AdamC19/Musical_SSTC_Driver/README.md

# Musical Solid-State Tesla Coil Project
These are the hardware source files for my 2022 revision of my musical solid-state Tesla coil driver. 

This is a completely analog design. No firmware!

## Concept
The concept is not far off from my previous design, except for a few notable differences.
