AdamC19/Musical_SSTC_Driver/SSTC_Control_Board/README.md

# Control Board

Below is a simplified block-diagram of the control board:

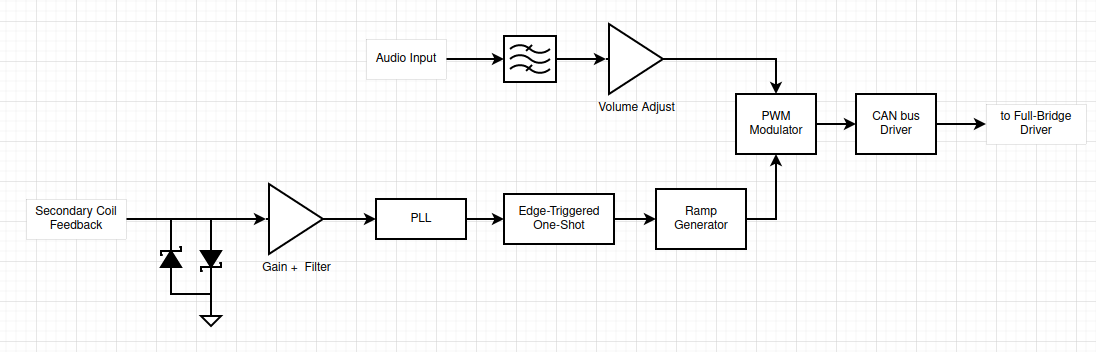
[picture p1: SSTC_Control_Board/imgs/control_board_block_diagram.png]
Control Board block diagram
