AdamC19/Musical_SSTC_Driver/SSTC_Full_Bridge_Driver/README.md

# Full-Bridge Driver
See below a simplified schematic of the full-bridge driver.

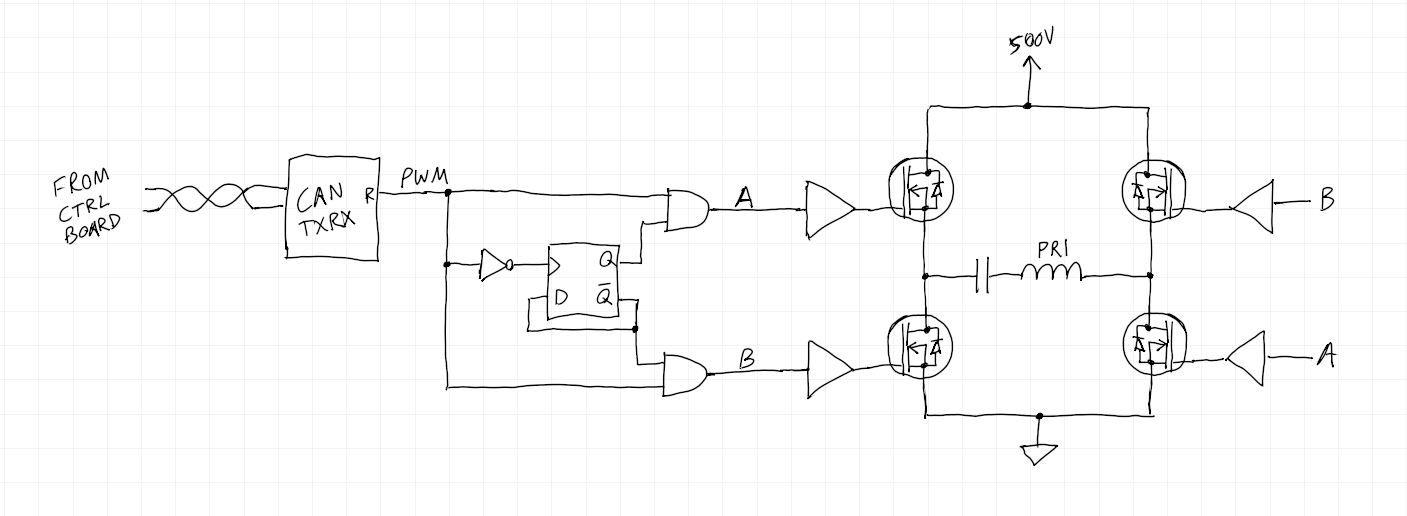
[picture p2: SSTC_Full_Bridge_Driver/imgs/full_bridge_simplified_schematic.png]
Simplified Schematic
