AdamC19/Musical_SSTC_Driver/SSTC_Switch_Board/SSTC_Switch_Board.step

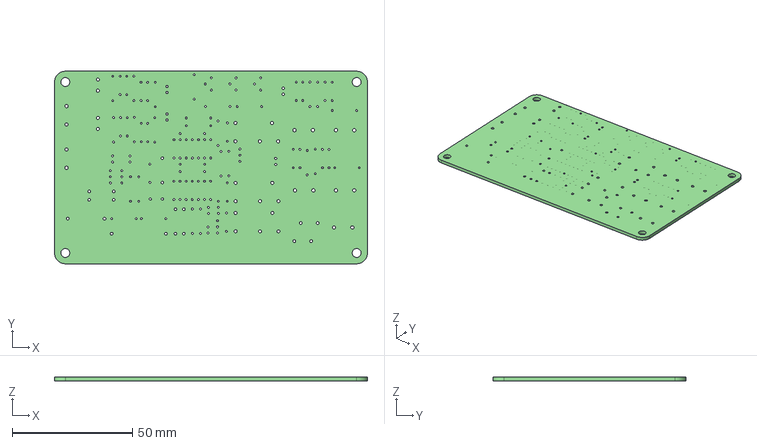
[picture p3: CAD file, 2022-02-14]
SSTC_Switch_Board/SSTC_Switch_Board.step
130.0 x 80.0 x 1.60 mm
