AdamC19/Musical_SSTC_Driver/SSTC_Control_Board/SSTC_Control_Board.kicad_pcb

## KiCad design SSTC_Control_Board/SSTC_Control_Board.kicad_pcb (2022-10-14)

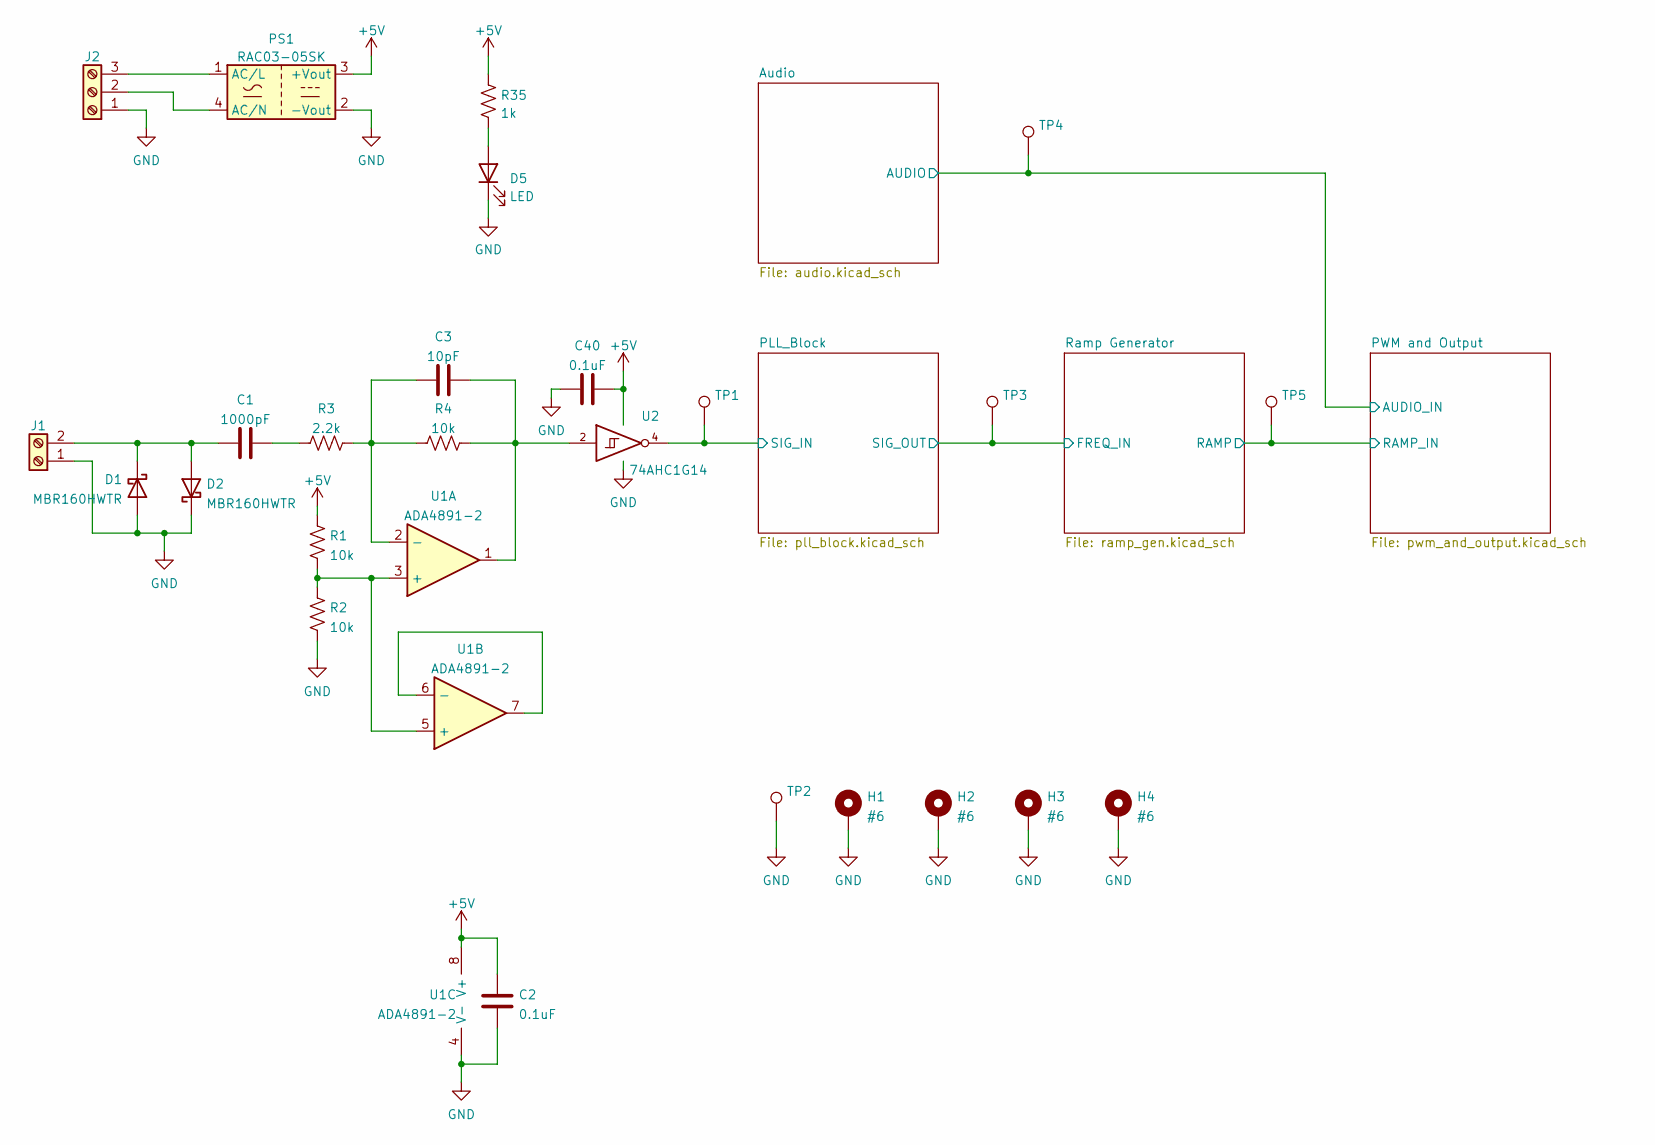
[picture p4: schematic SSTC_Control_Board.kicad_sch]

Parts:
C1: 1000pF; C_0603_1608Metric
C2, C40: 0.1uF; C_0603_1608Metric
C3: 10pF; C_0603_1608Metric
D1, D2: MBR160HWTR; D_SOD-123; MFG_PN MBR160HWTR
D5: LED; LED_0603_1608Metric
H1, H2, H3, H4: #6; MountingHole_3.7mm_Pad_Via
J1: Screw_Terminal_01x02; PhoenixContact_MC_1,5_2-G-3.81_1x02_P3.81mm_Horizontal
J2: Screw_Terminal_01x03; PhoenixContact_GMSTBA_2,5_3-G-7,62_1x03_P7.62mm_Horizontal
PS1: RAC03-05SK; RAC03-K; MFG_PN RAC03-05SK
R1, R2, R4: 10k; R_0805_2012Metric
R3: 2.2k; R_0805_2012Metric
R35: 1k; R_0805_2012Metric
TP1, TP2, TP3, TP4, TP5: TestPoint; TestPoint_Bridge_Pitch2.54mm_Drill1.0mm
U1: ADA4891-2; SOIC-8_3.9x4.9mm_P1.27mm
U2: 74AHC1G14; SOT-23-5

Connections:
+5V: C2.2, C40.1, PS1.3 (+Vout), R1.1, R35.2, U1.8 (V+), U2.5 (VCC); also elsewhere on the board
/Audio/AUDIO: TP4.1; also elsewhere on the board
/PLL_Block/SIG_IN: TP1.1, U2.4; also elsewhere on the board
/PLL_Block/SIG_OUT: TP3.1; also elsewhere on the board
/PWM and Output/RAMP_IN: TP5.1; also elsewhere on the board
GND: C2.1, C40.2, D1.2 (A), D2.1 (K), D5.1 (K), H1.1, H2.1, H3.1, H4.1, J1.1, J2.1, PS1.2 (-Vout), R2.2, TP2.1, U1.4 (V-), U2.3 (GND); also elsewhere on the board
unnamed: C1.1, D1.1 (K), D2.2 (A), J1.2
unnamed: C1.2, R3.1
unnamed: C3.1, R3.2, R4.1, U1.2 (-)
unnamed: C3.2, R4.2, U1.1, U2.2
unnamed: D5.2 (A), R35.1
unnamed: J2.2, PS1.4 (AC/N)
unnamed: J2.3, PS1.1 (AC/L)
unnamed: R1.2, R2.1, U1.3 (+), U1.5 (+)
unnamed: U1.6 (-), U1.7

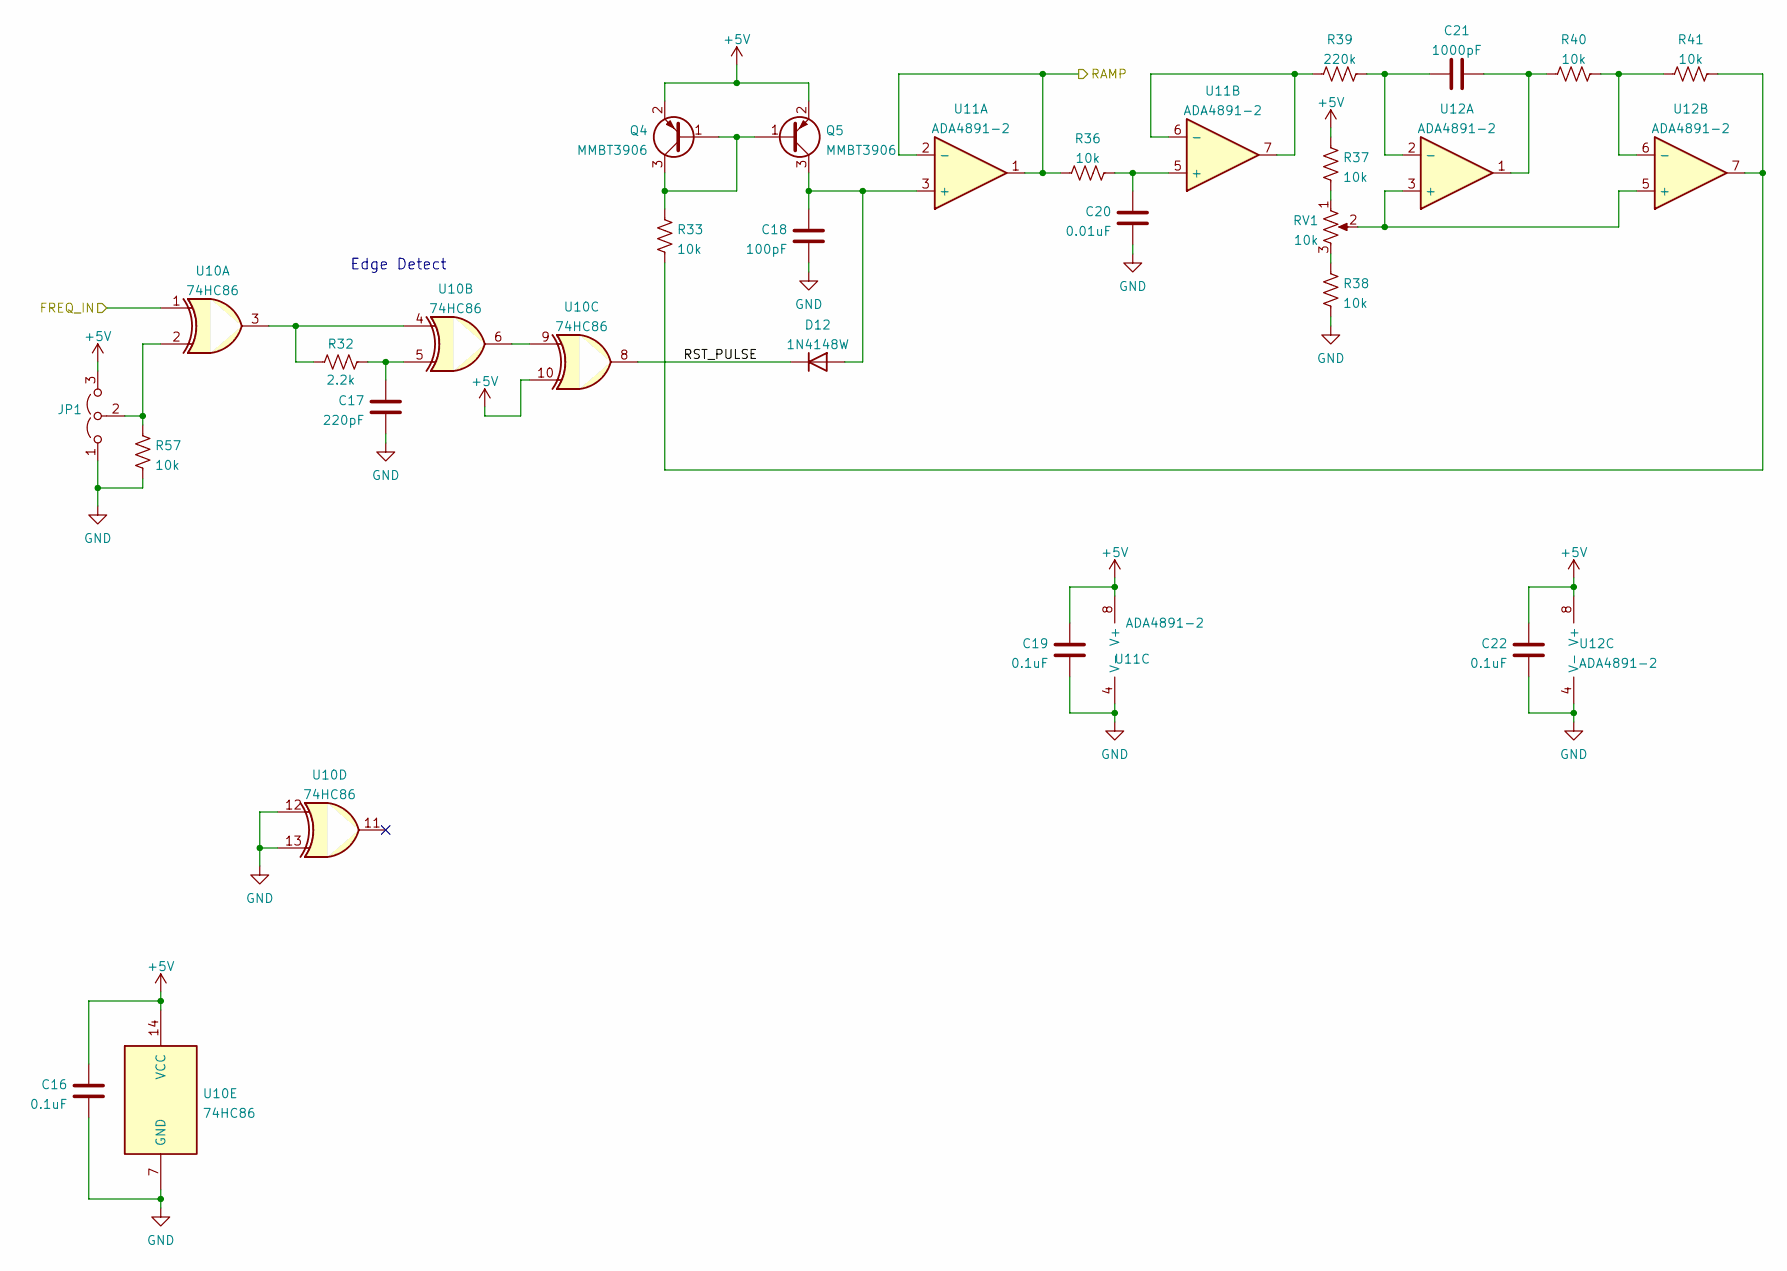
[picture p5: schematic ramp_gen.kicad_sch]

Parts:
C16, C19, C22: 0.1uF; C_0603_1608Metric
C17: 220pF; C_0603_1608Metric
C18: 100pF; C_0603_1608Metric
C20: 0.01uF; C_0603_1608Metric
C21: 1000pF; C_0603_1608Metric
D12: 1N4148W; D_SOD-123
JP1: Jumper_3_Open; PinHeader_1x03_P2.54mm_Vertical
Q4, Q5: MMBT3906; SOT-23
R32: 2.2k; R_0805_2012Metric
R33, R36, R37, R38, R40, R41, R57: 10k; R_0805_2012Metric
R39: 220k; R_0805_2012Metric
RV1: 10k; Potentiometer_Bourns_3386P_Vertical
U10: 74HC86; SOIC-14_3.9x8.7mm_P1.27mm
U11, U12: ADA4891-2; SOIC-8_3.9x4.9mm_P1.27mm

Connections:
+5V: C16.1, C19.1, C22.1, JP1.3 (B), Q4.2 (E), Q5.2 (E), R37.2, U10.10, U10.14 (VCC), U11.8 (V+), U12.8 (V+); also elsewhere on the board
/PLL_Block/SIG_OUT: U10.1; also elsewhere on the board
/PWM and Output/RAMP_IN: R36.1, U11.1, U11.2 (-); also elsewhere on the board
/Ramp Generator/RST_PULSE: D12.1 (K), U10.8
GND: C16.2, C17.2, C18.2, C19.2, C20.2, C22.2, JP1.1 (A), R38.1, R57.1, U10.7 (GND), U10.12, U10.13, U11.4 (V-), U12.4 (V-); also elsewhere on the board
unnamed: C17.1, R32.1, U10.5
unnamed: C18.1, D12.2 (A), Q5.3 (C), U11.3 (+)
unnamed: C20.1, R36.2, U11.5 (+)
unnamed: C21.1, R39.1, U12.2 (-)
unnamed: C21.2, R40.2, U12.1
unnamed: JP1.2 (C), R57.2, U10.2
unnamed: Q4.1 (B), Q4.3 (C), Q5.1 (B), R33.1
unnamed: R32.2, U10.3, U10.4
unnamed: R33.2, R41.1, U12.7
unnamed: R37.1, RV1.1
unnamed: R38.2, RV1.3
unnamed: R39.2, U11.6 (-), U11.7
unnamed: R40.1, R41.2, U12.6 (-)
unnamed: RV1.2, U12.3 (+), U12.5 (+)
unnamed: U10.6, U10.9

Notes on the sheet:
Edge Detect

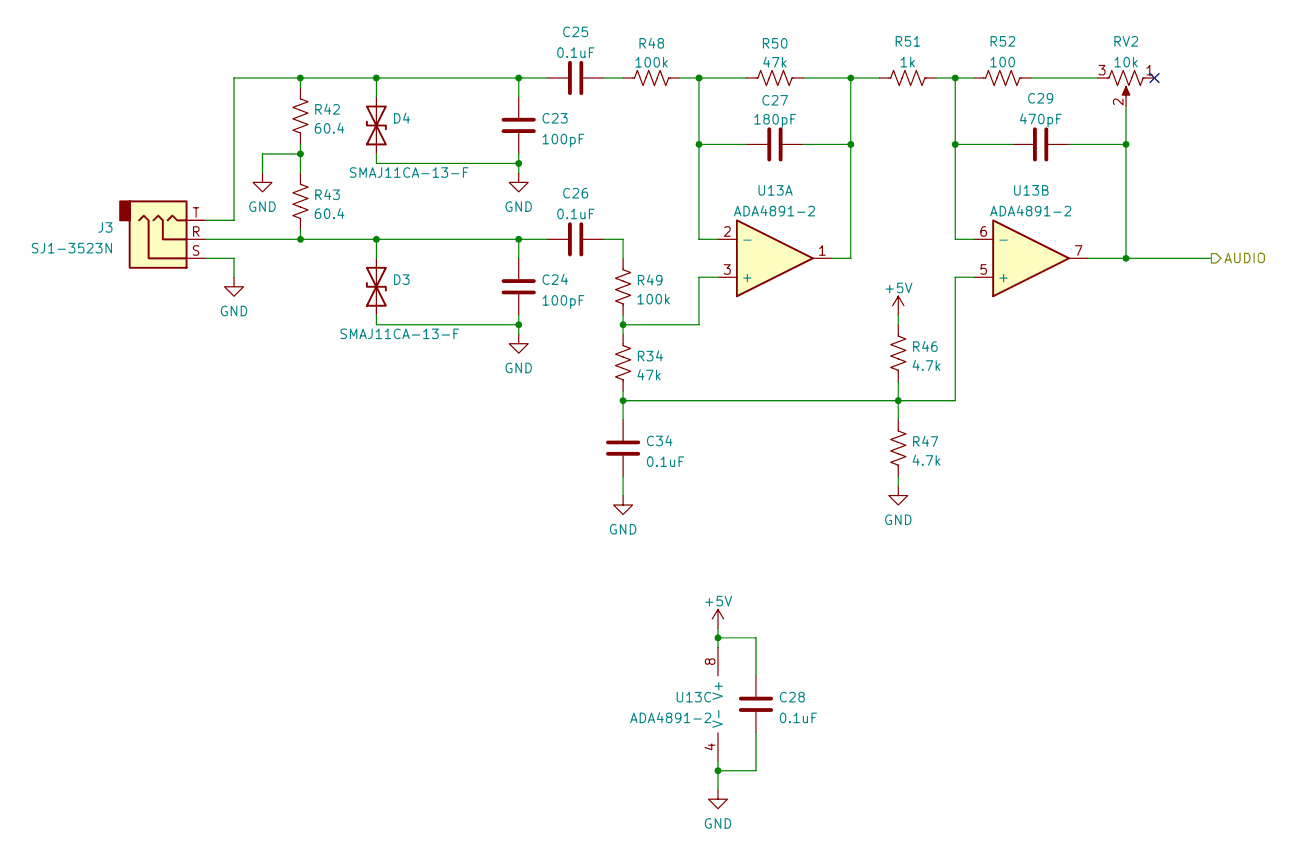
[picture p6: schematic audio.kicad_sch]

Parts:
C23, C24: 100pF; C_0603_1608Metric
C25, C26, C28, C34: 0.1uF; C_0603_1608Metric
C27: 180pF; C_0603_1608Metric
C29: 470pF; C_0603_1608Metric
D3, D4: SMAJ11CA-13-F; D_SMA; MFG_PN SMAJ11CA-13-F
J3: SJ1-3523N; Jack_3.5mm_CUI_SJ1-3523N_Horizontal; MFG_PN SJ1-3523N
R34, R50: 47k; R_0805_2012Metric
R42, R43: 60.4; R_0805_2012Metric
R46, R47: 4.7k; R_0805_2012Metric
R48, R49: 100k; R_0805_2012Metric
R51: 1k; R_0805_2012Metric
R52: 100; R_0805_2012Metric
RV2: 10k; Potentiometer_Bourns_PTV09A-2_Single_Horizontal; MFG_PN PTV09A-2020F-A103
U13: ADA4891-2; SOIC-8_3.9x4.9mm_P1.27mm

Connections:
+5V: C28.2, R46.2, U13.8 (V+); also elsewhere on the board
/Audio/AUDIO: C29.1, RV2.2, U13.7; also elsewhere on the board
GND: C23.1, C24.1, C28.1, C34.1, D3.1 (A1), D4.1 (A1), J3.S, R42.2, R43.1, R47.1, U13.4 (V-); also elsewhere on the board
unnamed: C23.2, C25.2, D4.2 (A2), J3.T, R42.1
unnamed: C24.2, C26.2, D3.2 (A2), J3.R, R43.2
unnamed: C25.1, R48.1
unnamed: C26.1, R49.2
unnamed: C27.1, R50.2, R51.1, U13.1
unnamed: C27.2, R48.2, R50.1, U13.2 (-)
unnamed: C29.2, R51.2, R52.2, U13.6 (-)
unnamed: C34.2, R34.1, R46.1, R47.2, U13.5 (+)
unnamed: R34.2, R49.1, U13.3 (+)
unnamed: R52.1, RV2.3

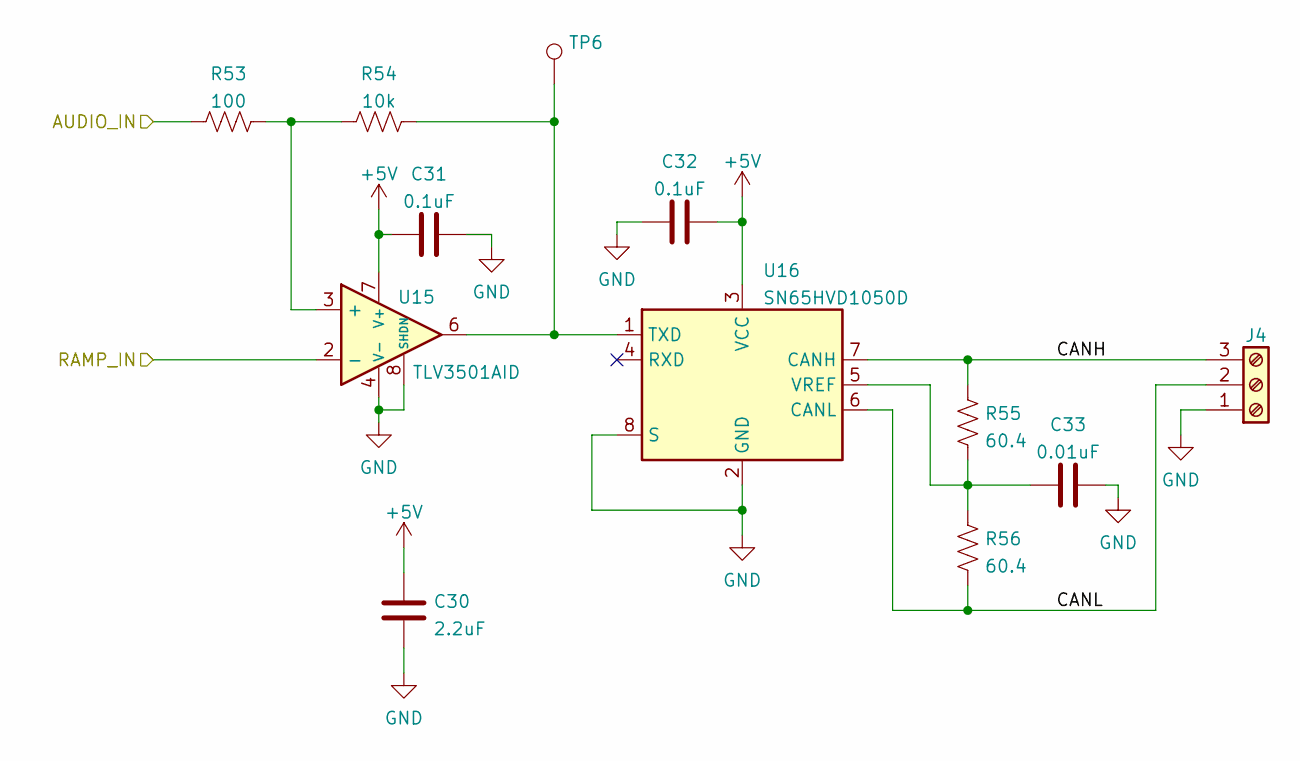
[picture p7: schematic pwm_and_output.kicad_sch]

Parts:
C30: 2.2uF; C_0805_2012Metric
C31, C32: 0.1uF; C_0603_1608Metric
C33: 0.01uF; C_0603_1608Metric
J4: Screw_Terminal_01x03; PhoenixContact_MC_1,5_3-G-3.81_1x03_P3.81mm_Horizontal
R53: 100; R_0805_2012Metric
R54: 10k; R_0805_2012Metric
R55, R56: 60.4; R_0805_2012Metric
TP6: TestPoint; TestPoint_Bridge_Pitch2.54mm_Drill1.0mm
U15: TLV3501AID; SOIC-8_3.9x4.9mm_P1.27mm
U16: SN65HVD1050D; SOIC-8_3.9x4.9mm_P1.27mm

Connections:
+5V: C30.2, C31.1, C32.1, U15.7 (V+), U16.3 (VCC); also elsewhere on the board
/Audio/AUDIO: R53.2; also elsewhere on the board
/PWM and Output/CANH: J4.3, R55.1, U16.7 (CANH)
/PWM and Output/CANL: J4.2, R56.2, U16.6 (CANL)
/PWM and Output/RAMP_IN: U15.2 (-); also elsewhere on the board
GND: C30.1, C31.2, C32.2, C33.2, J4.1, U15.4 (V-), U15.8 (SHDN), U16.2 (GND), U16.8 (S); also elsewhere on the board
unnamed: C33.1, R55.2, R56.1, U16.5 (VREF)
unnamed: R53.1, R54.1, U15.3 (+)
unnamed: R54.2, TP6.1, U15.6, U16.1 (TXD)

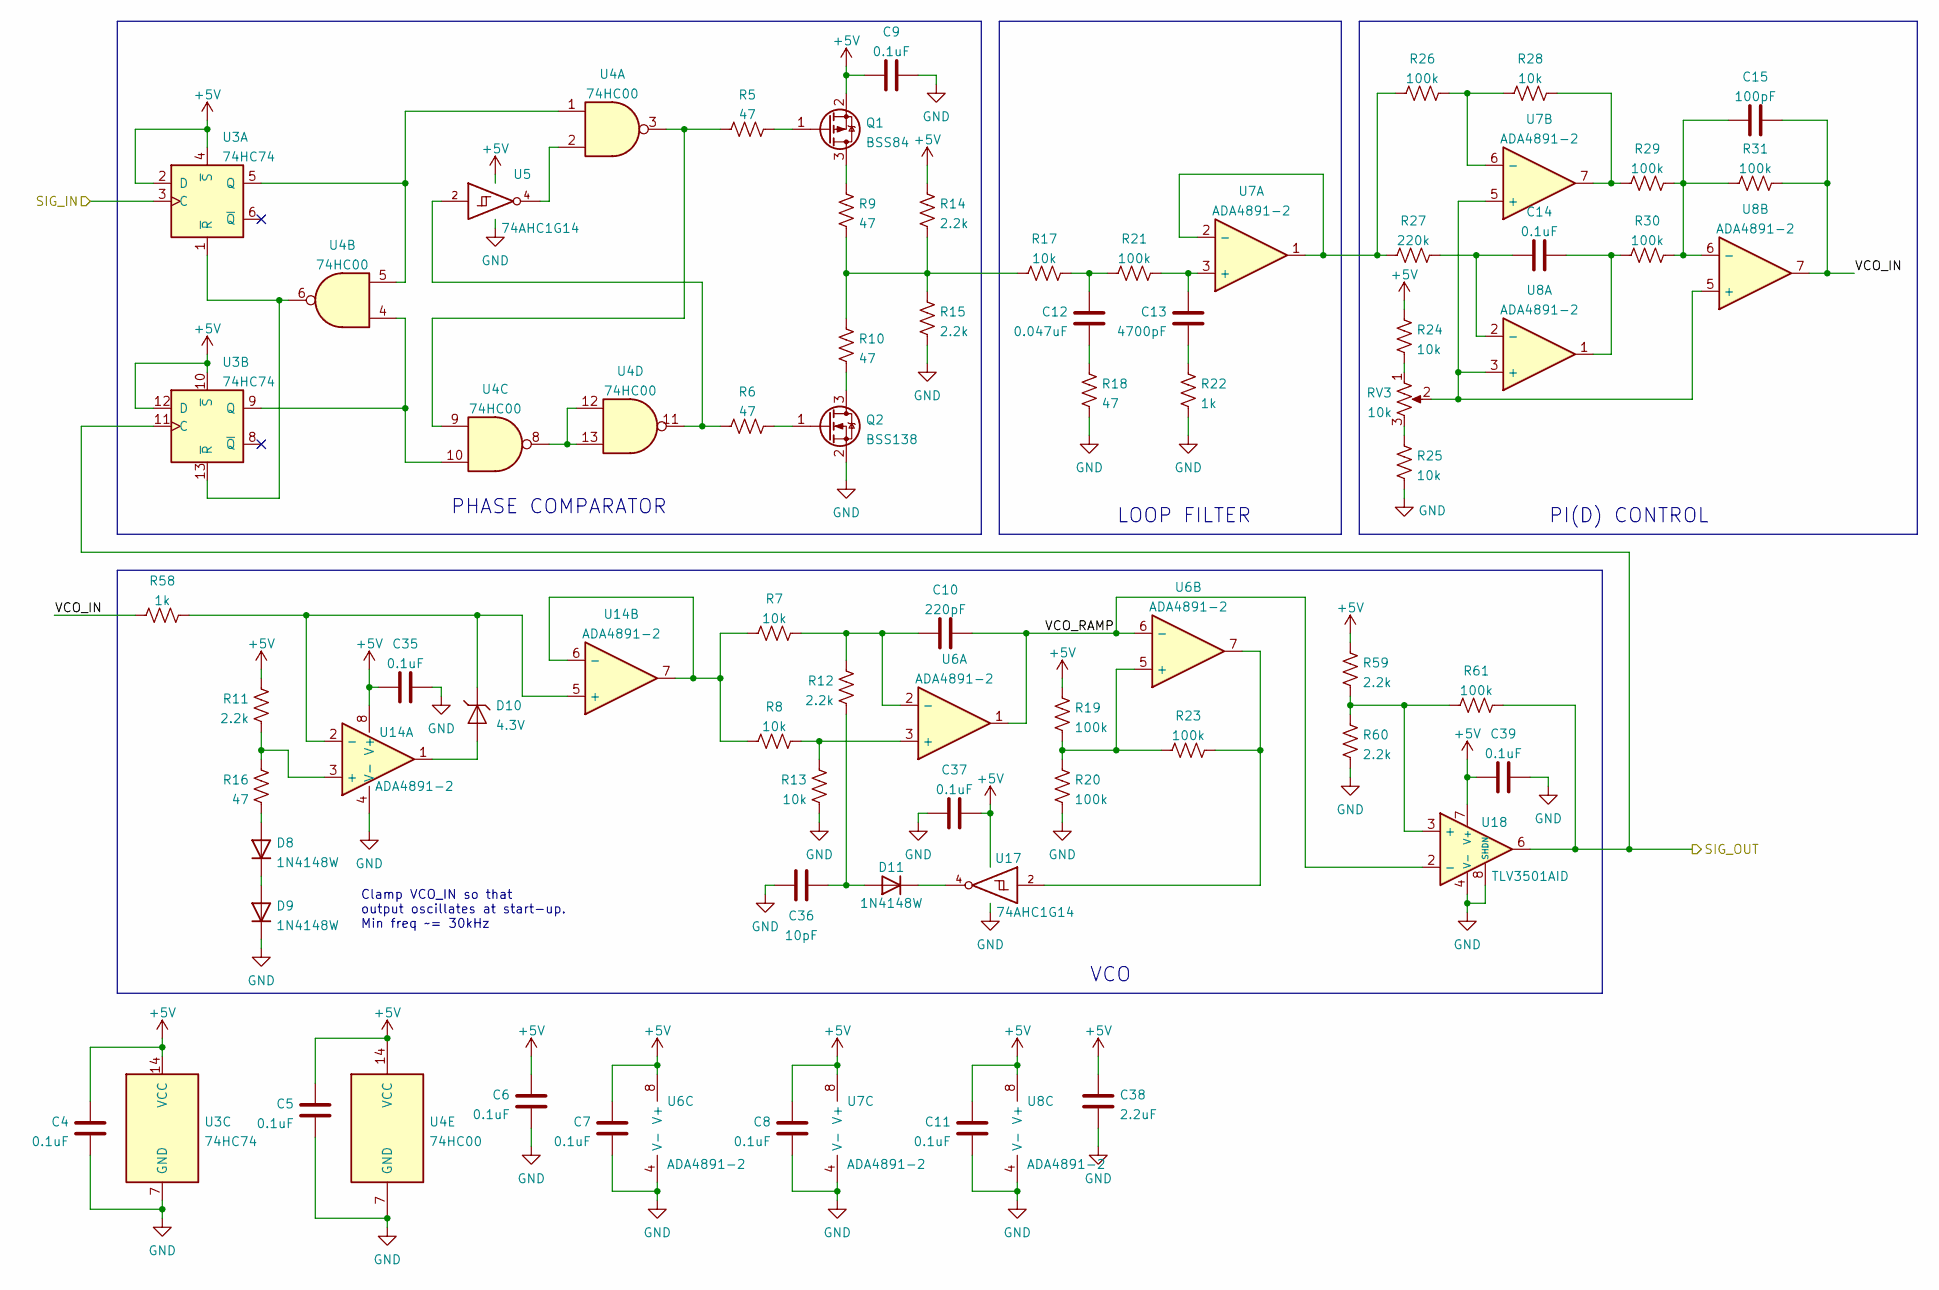
[picture p8: schematic pll_block.kicad_sch]

Parts:
C4, C5, C6, C7, C8, C9, C11, C14, C35, C37, C39: 0.1uF; C_0603_1608Metric
C10: 220pF; C_0603_1608Metric
C12: 0.047uF; C_0603_1608Metric
C13: 4700pF; C_0603_1608Metric
C15: 100pF; C_0603_1608Metric
C36: 10pF; C_0603_1608Metric
C38: 2.2uF; C_0805_2012Metric
D8, D9, D11: 1N4148W; D_SOD-123
D10: 4.3V; D_SOD-123; MFG_PN BZT52C4V3
Q1: BSS84; SOT-23
Q2: BSS138; SOT-23
R5, R6, R9, R10, R16, R18: 47; R_0805_2012Metric
R7, R8, R13, R17, R24, R25, R28: 10k; R_0805_2012Metric
R11, R12, R14, R15, R59, R60: 2.2k; R_0805_2012Metric
R19, R20, R21, R23, R26, R29, R30, R31, R61: 100k; R_0805_2012Metric
R22, R58: 1k; R_0805_2012Metric
R27: 220k; R_0805_2012Metric
RV3: 10k; Potentiometer_Bourns_3386P_Vertical
U3: 74HC74; SOIC-14_3.9x8.7mm_P1.27mm
U4: 74HC00; SOIC-14_3.9x8.7mm_P1.27mm
U5, U17: 74AHC1G14; SOT-23-5
U6, U7, U8, U14: ADA4891-2; SOIC-8_3.9x4.9mm_P1.27mm
U18: TLV3501AID; SOIC-8_3.9x4.9mm_P1.27mm

Connections:
+5V: C4.1, C5.1, C6.1, C7.1, C8.1, C9.1, C11.1, C35.1, C37.2, C38.2, C39.1, Q1.2 (S), R11.2, R14.2, R19.1, R24.1, R59.1, U3.2 (D), U3.4 (~S), U3.10 (~S), U3.12 (D), U3.14 (VCC), U4.14 (VCC), U5.5 (VCC), U6.8 (V+), U7.8 (V+), U8.8 (V+), U14.8 (V+), U17.5 (VCC), U18.7 (V+); also elsewhere on the board
/PLL_Block/SIG_IN: U3.3 (C); also elsewhere on the board
/PLL_Block/SIG_OUT: R61.2, U3.11 (C), U18.6; also elsewhere on the board
/PLL_Block/VCO_IN: C15.2, R31.1, R58.2, U8.7
/PLL_Block/VCO_RAMP: C10.2, U6.1, U6.6 (-), U18.2 (-)
GND: C4.2, C5.2, C6.2, C7.2, C8.2, C9.2, C11.2, C35.2, C36.1, C37.1, C38.1, C39.2, D9.1 (K), Q2.2 (S), R13.1, R15.1, R18.1, R20.2, R22.1, R25.2, R60.2, U3.7 (GND), U4.7 (GND), U5.3 (GND), U6.4 (V-), U7.4 (V-), U8.4 (V-), U14.4 (V-), U17.3 (GND), U18.4 (V-), U18.8 (SHDN); also elsewhere on the board
unnamed: C10.1, R7.2, R12.2, U6.2 (-)
unnamed: C12.1, R17.1, R21.2
unnamed: C12.2, R18.2
unnamed: C13.1, R21.1, U7.3 (+)
unnamed: C13.2, R22.2
unnamed: C14.1, R27.1, U8.2 (-)
unnamed: C14.2, R30.2, U8.1
unnamed: C15.1, R29.1, R30.1, R31.2, U8.6 (-)
unnamed: C36.2, D11.2 (A), R12.1
unnamed: D8.1 (K), D9.2 (A)
unnamed: D8.2 (A), R16.1
unnamed: D10.1 (K), R58.1, U14.2 (-), U14.5 (+)
unnamed: D10.2 (A), U14.1
unnamed: D11.1 (K), U17.4
unnamed: Q1.1 (G), R5.2
unnamed: Q1.3 (D), R9.2
unnamed: Q2.1 (G), R6.2
unnamed: Q2.3 (D), R10.1
unnamed: R5.1, U4.3, U4.9
unnamed: R6.1, U4.11, U5.2
unnamed: R7.1, R8.2, U14.6 (-), U14.7
unnamed: R9.1, R10.2, R14.1, R15.2, R17.2
unnamed: R11.1, R16.2, U14.3 (+)
unnamed: R8.1, R13.2, U6.3 (+)
unnamed: R19.2, R20.1, R23.1, U6.5 (+)
unnamed: R23.2, U6.7, U17.2
unnamed: R24.2, RV3.1
unnamed: R25.1, RV3.3
unnamed: R26.1, R28.2, U7.6 (-)
unnamed: R26.2, R27.2, U7.1, U7.2 (-)
unnamed: R28.1, R29.2, U7.7
unnamed: R59.2, R60.1, R61.1, U18.3 (+)
unnamed: RV3.2, U7.5 (+), U8.3 (+), U8.5 (+)
unnamed: U3.1 (~R), U3.13 (~R), U4.6
unnamed: U3.5 (Q), U4.1, U4.5
unnamed: U3.9 (Q), U4.4, U4.10
unnamed: U4.2, U5.4
unnamed: U4.8, U4.12, U4.13

Notes on the sheet:
LOOP FILTER
Clamp VCO_IN so that output oscillates at start-up. Min freq ~= 30kHz
VCO
PI(D) CONTROL
PHASE COMPARATOR

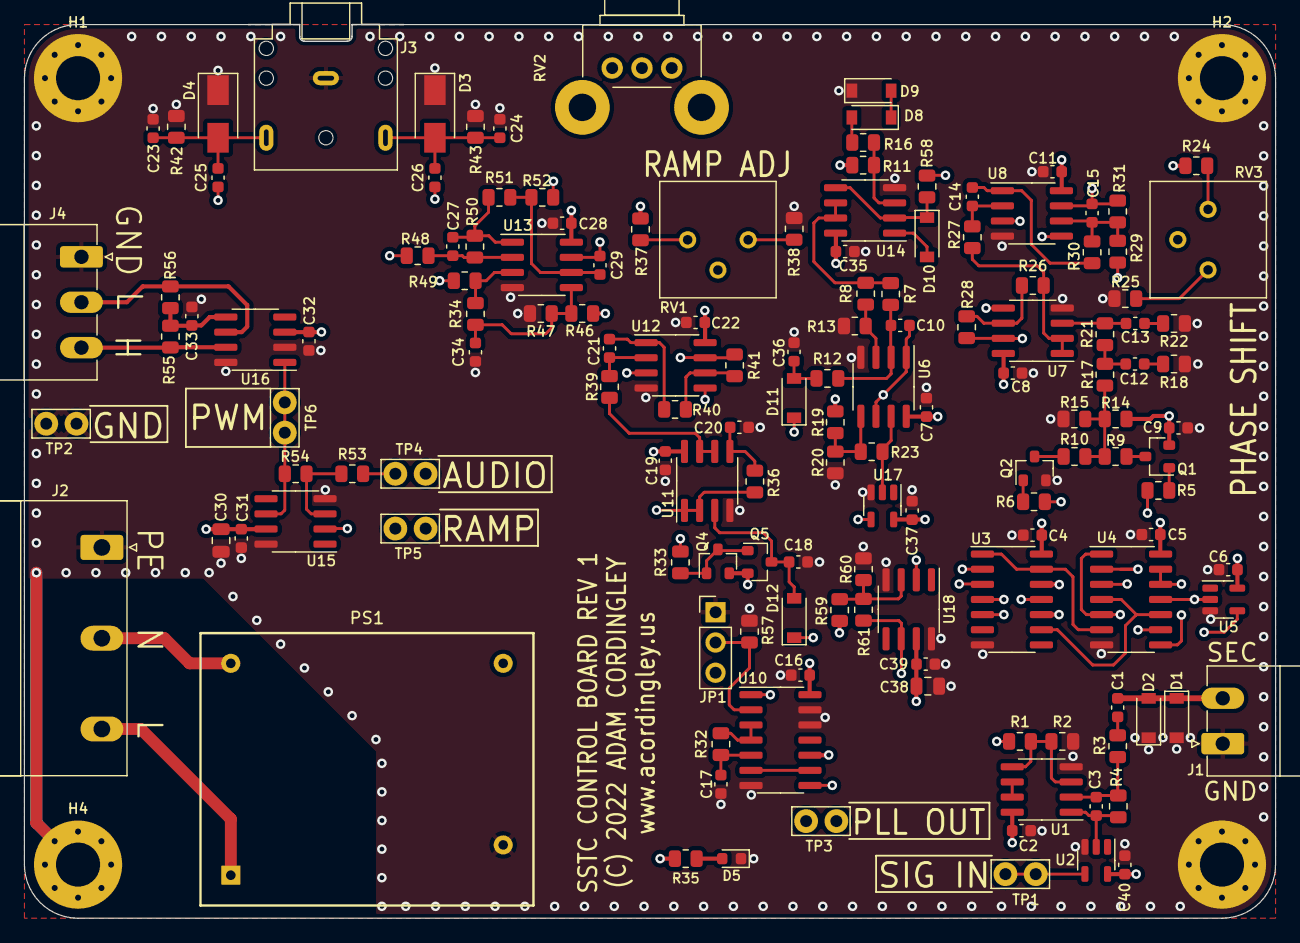
[picture p9: board SSTC_Control_Board.kicad_pcb from above]

Board: 4 copper layers, 105.0 x 75.0 mm, 149 parts (0 on the bottom side), 86 nets.
