AdamC19/Musical_SSTC_Driver/Audio_Isolator/Audio_Isolator.kicad_pcb

## KiCad design Audio_Isolator/Audio_Isolator.kicad_pcb (2022-10-14)

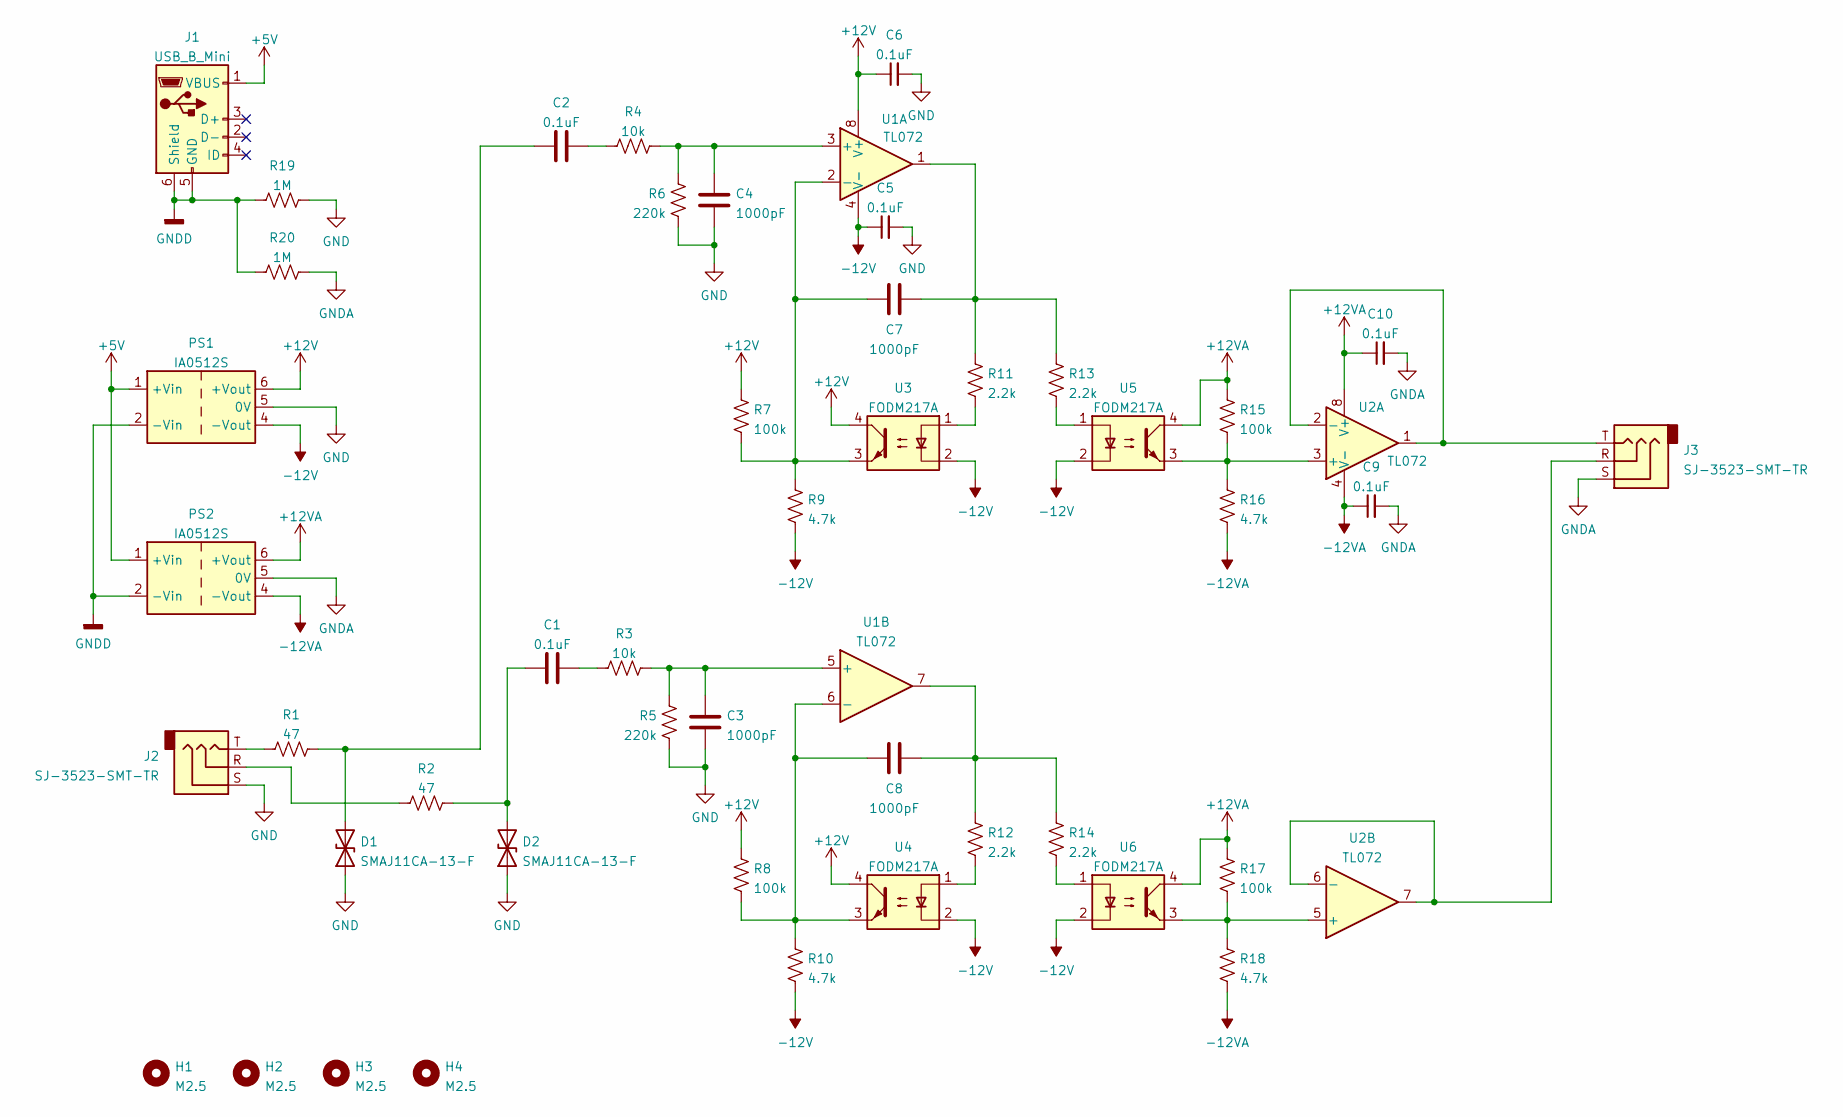
[picture p10: schematic Audio_Isolator.kicad_sch]

Parts:
C1, C2, C5, C6, C9, C10: 0.1uF; C_0603_1608Metric
C3, C4, C7, C8: 1000pF; C_0603_1608Metric
D1, D2: SMAJ11CA-13-F; D_SMA; MFG_PN SMAJ11CA-13-F
H1, H2, H3, H4: M2.5; MountingHole_2.7mm_M2.5_Pad
J1: USB_B_Mini; USB_Mini-B_Wuerth_65100516121_Horizontal
J2, J3: SJ-3523-SMT-TR; Jack_3.5mm_CUI_SJ-3523-SMT_Horizontal; MFG_PN SJ-3523-SMT-TR
PS1, PS2: IA0512S; Converter_DCDC_XP_POWER-IAxxxxS_THT
R1, R2: 47; R_0805_2012Metric
R3, R4: 10k; R_0805_2012Metric
R5, R6: 220k; R_0805_2012Metric
R7, R8, R15, R17: 100k; R_0805_2012Metric
R9, R10, R16, R18: 4.7k; R_0805_2012Metric
R11, R12, R13, R14: 2.2k; R_0805_2012Metric
R19, R20: 1M; R_2512_6332Metric
U1, U2: TL072; SOIC-8_3.9x4.9mm_P1.27mm
U3, U4, U5, U6: FODM217A; SOP-4_4.4x2.6mm_P1.27mm

Connections:
+5V: J1.1 (VBUS), PS1.1 (+Vin), PS2.1 (+Vin)
+12V: C6.1, PS1.6 (+Vout), R7.1, R8.1, U1.8 (V+), U3.4, U4.4
+12VA: C10.1, PS2.6 (+Vout), R15.1, R17.1, U2.8 (V+), U5.4, U6.4
-12V: C5.1, PS1.4 (-Vout), R9.2, R10.2, U1.4 (V-), U3.2, U4.2, U5.2, U6.2
-12VA: C9.1, PS2.4 (-Vout), R16.2, R18.2, U2.4 (V-)
GND: C3.2, C4.2, C5.2, C6.2, D1.1 (A1), D2.1 (A1), J2.S, PS1.5 (0V), R5.2, R6.2, R19.2
GNDA: C9.2, C10.2, J3.S, PS2.5 (0V), R20.2
GNDD: J1.5 (GND), J1.6 (Shield), PS1.2 (-Vin), PS2.2 (-Vin), R19.1, R20.1
unnamed: C1.1, D2.2 (A2), R2.2
unnamed: C1.2, R3.1
unnamed: C2.1, D1.2 (A2), R1.2
unnamed: C2.2, R4.1
unnamed: J2.R, R2.1
unnamed: J2.T, R1.1
unnamed: R11.2, U3.1
unnamed: R12.2, U4.1
unnamed: R13.2, U5.1
unnamed: R14.2, U6.1
unnamed: C7.1, R11.1, R13.1, U1.1
unnamed: C7.2, R7.2, R9.1, U1.2 (-), U3.3
unnamed: C4.1, R4.2, R6.1, U1.3 (+)
unnamed: C3.1, R3.2, R5.1, U1.5 (+)
unnamed: C8.2, R8.2, R10.1, U1.6 (-), U4.3
unnamed: C8.1, R12.1, R14.1, U1.7
unnamed: J3.T, U2.1, U2.2 (-)
unnamed: R15.2, R16.1, U2.3 (+), U5.3
unnamed: R17.2, R18.1, U2.5 (+), U6.3
unnamed: J3.R, U2.6 (-), U2.7

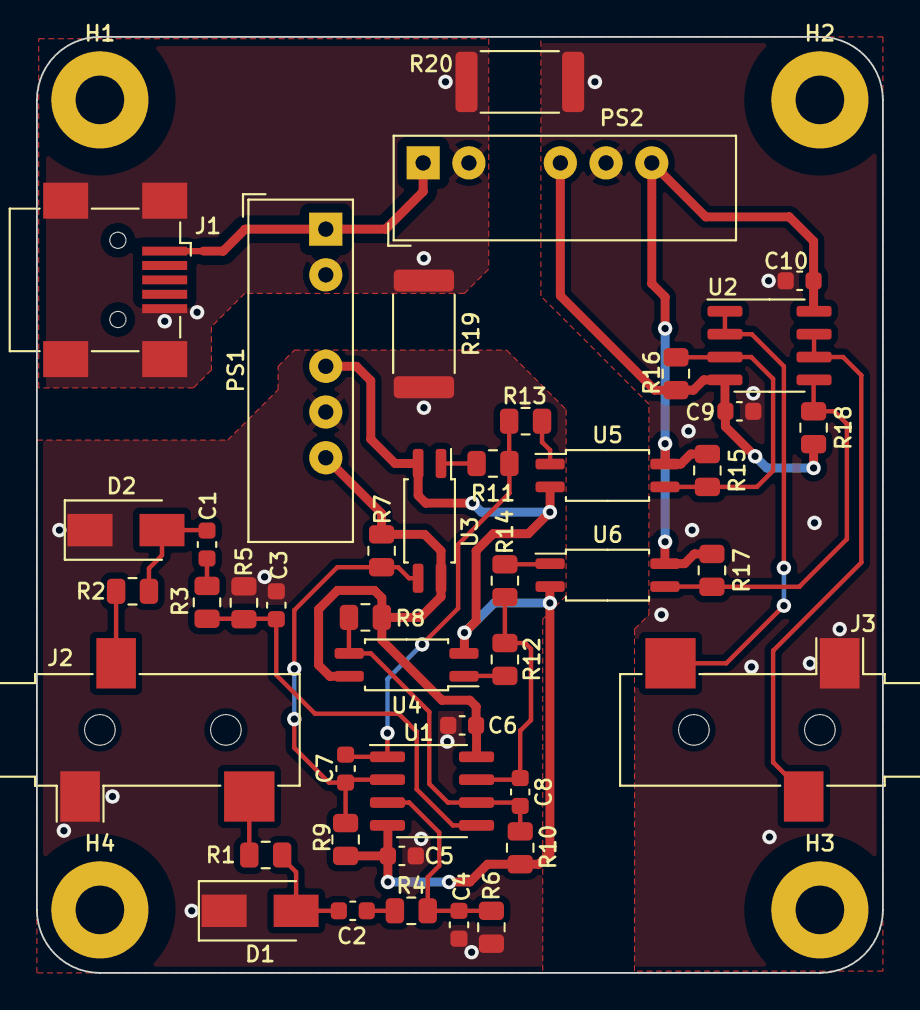
[picture p11: board Audio_Isolator.kicad_pcb from above]

Board: 2 copper layers, 47.0 x 52.0 mm, 47 parts (0 on the bottom side), 28 nets.
