AdamC19/Musical_SSTC_Driver/SSTC_Audio_Isolator/SSTC_Audio_Isolator.kicad_pcb

## KiCad design SSTC_Audio_Isolator/SSTC_Audio_Isolator.kicad_pcb (2022-10-14)

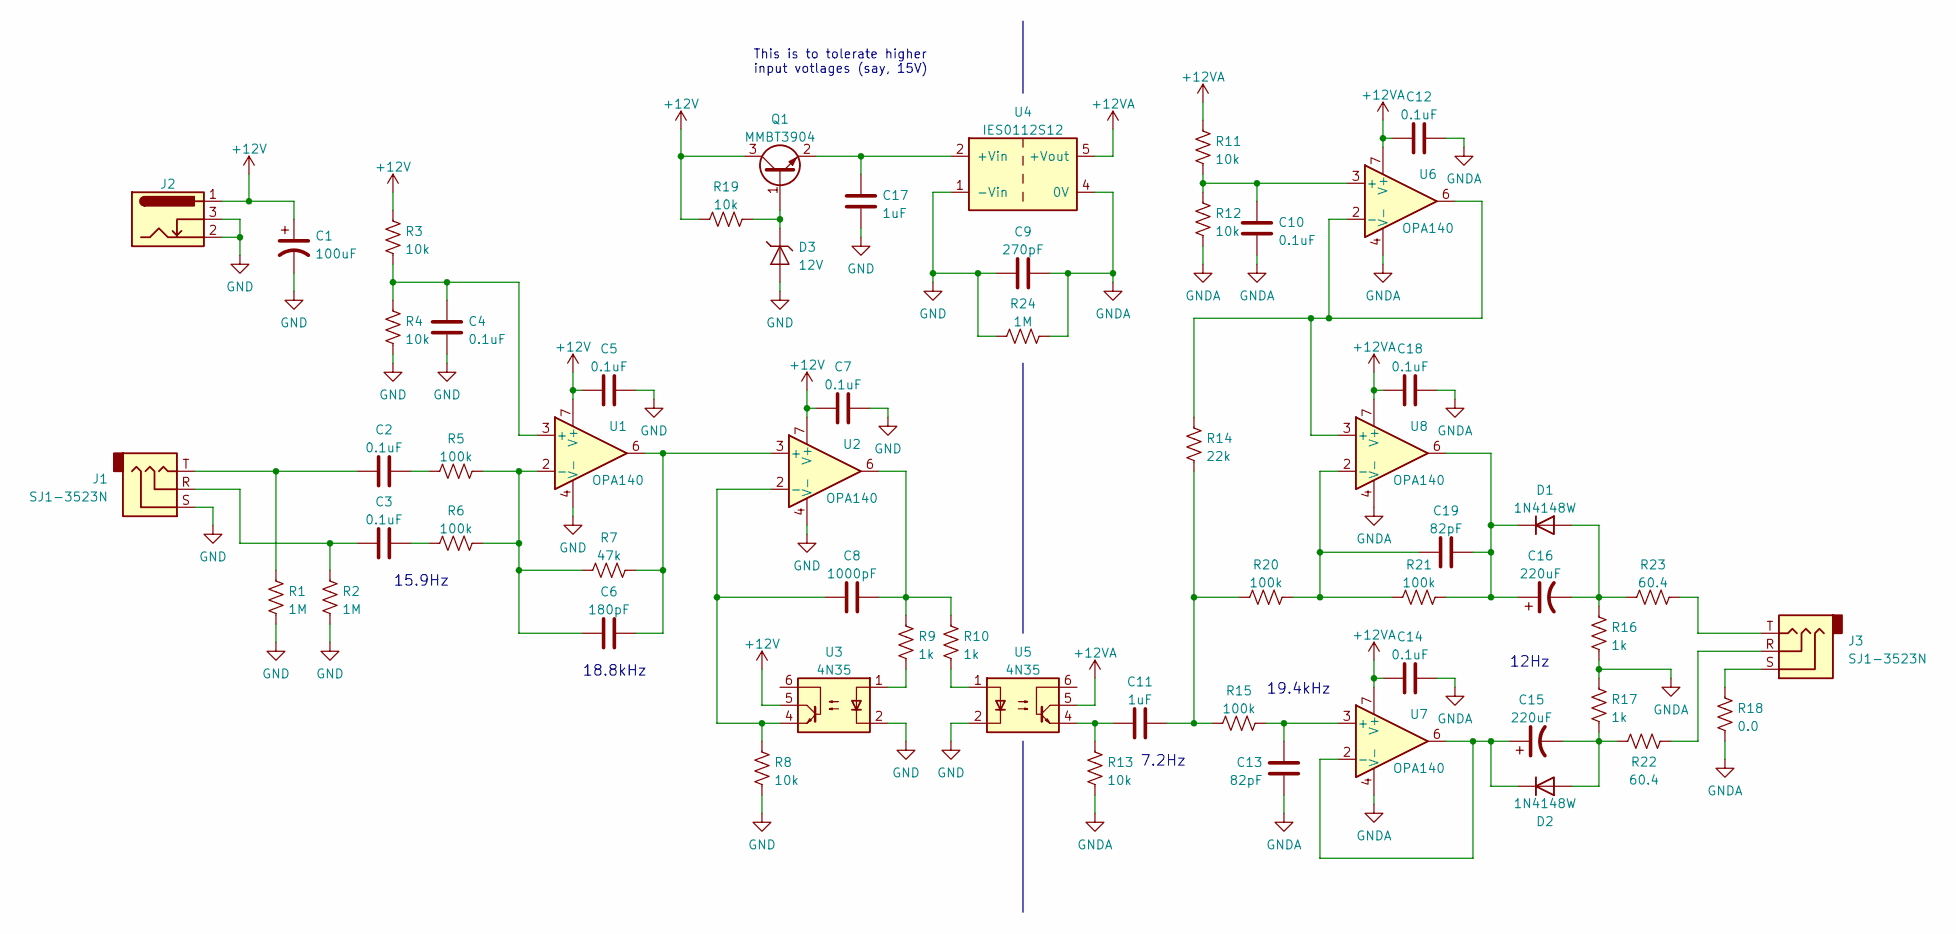
[picture p12: schematic SSTC_Audio_Isolator.kicad_sch]

Parts:
C1: 100uF; CP_Elec_6.3x9.9
C2, C3, C4, C5, C7, C10, C12, C14, C18: 0.1uF; C_0603_1608Metric
C6: 180pF; C_0603_1608Metric
C8: 1000pF; C_0603_1608Metric
C9: 270pF; C_1206_3216Metric
C11, C17: 1uF; C_0805_2012Metric
C13, C19: 82pF; C_0603_1608Metric
C15, C16: 220uF; CP_Elec_10x10
D1, D2: 1N4148W; D_SOD-123
D3: 12V; D_SOD-123
J1, J3: SJ1-3523N; Jack_3.5mm_CUI_SJ1-3523N_Horizontal; MFG_PN SJ1-3523N
J2: Barrel_Jack_Switch; BarrelJack_CUI_PJ-066A
Q1: MMBT3904; SOT-23
R1, R2: 1M; R_0603_1608Metric
R3, R4, R8, R11, R12, R13, R19: 10k; R_0603_1608Metric
R5, R6, R15, R20, R21: 100k; R_0603_1608Metric
R7: 47k; R_0603_1608Metric
R9, R10, R16, R17: 1k; R_0603_1608Metric
R14: 22k; R_0603_1608Metric
R18: 0.0; R_0805_2012Metric
R22, R23: 60.4; R_0805_2012Metric
R24: 1M; R_1206_3216Metric
U1, U2, U6, U7, U8: OPA140; SOIC-8_3.9x4.9mm_P1.27mm
U3, U5: 4N35; DIP-6_W7.62mm
U4: IES0112S12; XP_Power_ISE

Connections:
+12V: C1.1, C5.1, C7.1, J2.1, Q1.3 (C), R3.1, R19.1, U1.7 (V+), U2.7 (V+), U3.5
+12VA: C12.1, C14.1, C18.1, R11.2, U4.5 (+Vout), U5.5, U6.7 (V+), U7.7 (V+), U8.7 (V+)
GND: C1.2, C4.1, C5.2, C7.2, C9.1, C17.1, D3.2 (A), J1.S, J2.2, J2.3, R1.1, R2.1, R4.2, R8.1, R24.2, U1.4 (V-), U2.4 (V-), U3.2, U4.1 (-Vin), U5.2
GNDA: C9.2, C10.1, C12.2, C13.1, C14.2, C18.2, R12.1, R13.1, R16.1, R17.2, R18.1, R24.1, U4.4 (0V), U6.4 (V-), U7.4 (V-), U8.4 (V-)
unnamed: C2.1, J1.T, R1.2
unnamed: C2.2, R5.1
unnamed: C3.1, J1.R, R2.2
unnamed: C3.2, R6.1
unnamed: C4.2, R3.2, R4.1, U1.3 (+)
unnamed: C6.1, R5.2, R6.2, R7.1, U1.2 (-)
unnamed: C6.2, R7.2, U1.6, U2.3 (+)
unnamed: C8.1, R8.2, U2.2 (-), U3.4
unnamed: C8.2, R9.1, R10.1, U2.6
unnamed: C10.2, R11.1, R12.2, U6.3 (+)
unnamed: C11.1, R13.2, U5.4
unnamed: C11.2, R14.1, R15.2, R20.2
unnamed: C13.2, R15.1, U7.3 (+)
unnamed: C15.1, D2.1 (K), U7.2 (-), U7.6
unnamed: C15.2, D2.2 (A), R17.1, R22.2
unnamed: C16.1, C19.1, D1.1 (K), R21.1, U8.6
unnamed: C16.2, D1.2 (A), R16.2, R23.2
unnamed: C17.2, Q1.2 (E), U4.2 (+Vin)
unnamed: C19.2, R20.1, R21.2, U8.2 (-)
unnamed: D3.1 (K), Q1.1 (B), R19.2
unnamed: J3.R, R22.1
unnamed: J3.S, R18.2
unnamed: J3.T, R23.1
unnamed: R9.2, U3.1
unnamed: R10.2, U5.1
unnamed: R14.2, U6.2 (-), U6.6, U8.3 (+)

Notes on the sheet:
19.4kHz
7.2Hz
15.9Hz
This is to tolerate higher input votlages (say, 15V)
12Hz
18.8kHz
