AdamC19/Musical_SSTC_Driver/SSTC_Audio_Isolator/SSTC_Audio_Isolator.kicad_pcb

## KiCad design SSTC_Audio_Isolator/SSTC_Audio_Isolator.kicad_pcb (continued)

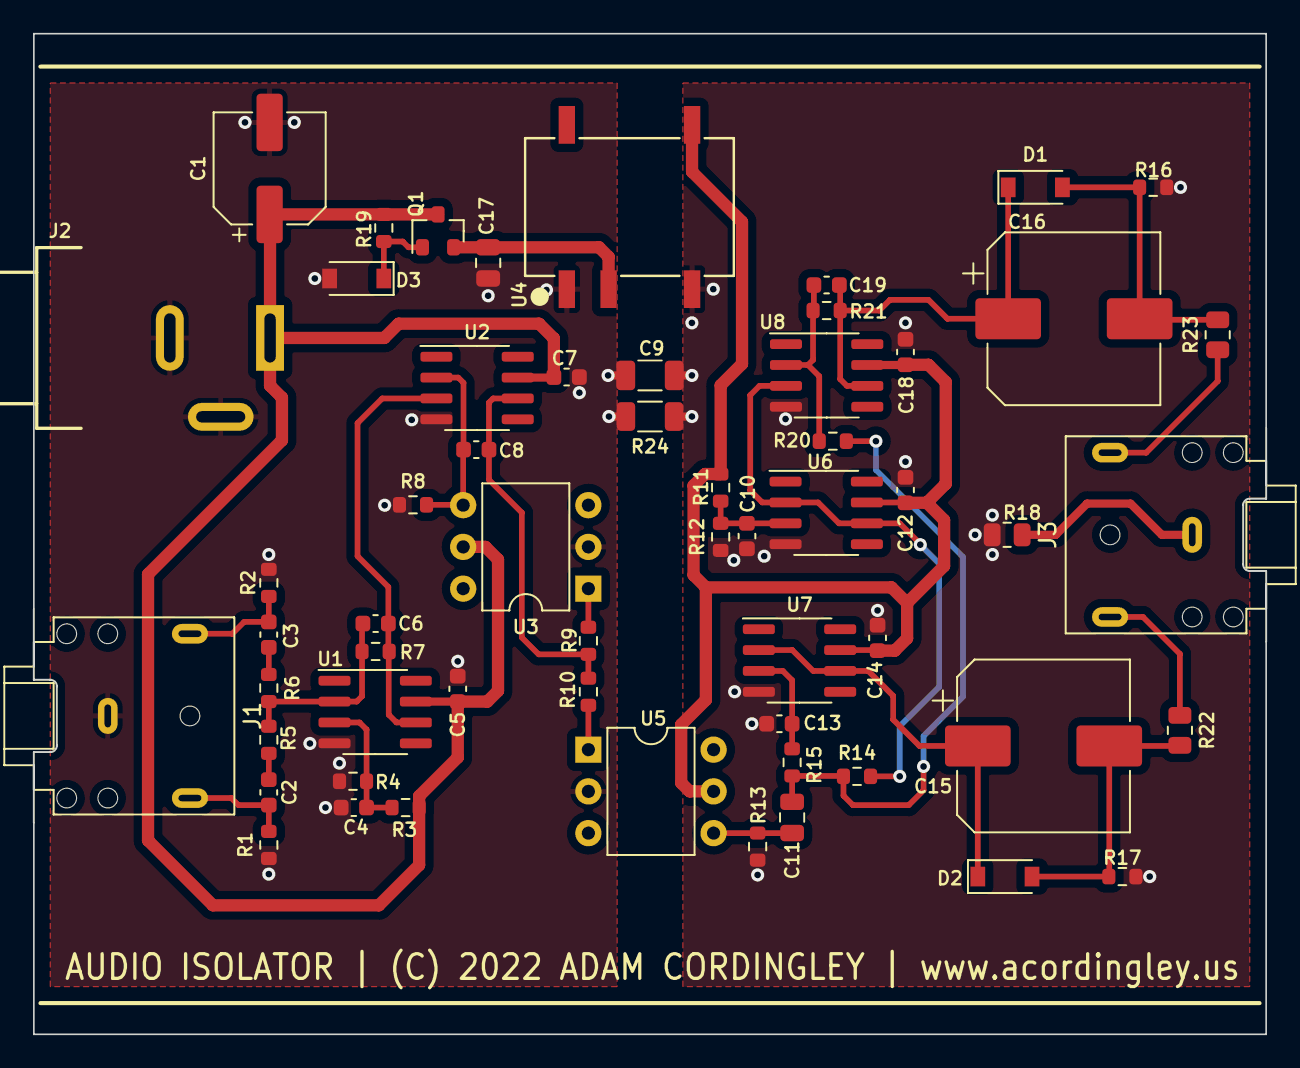
[picture p13: board SSTC_Audio_Isolator.kicad_pcb from above]

Board: 2 copper layers, 75.0 x 60.9 mm, 58 parts (0 on the bottom side), 30 nets.
