AdamC19/Musical_SSTC_Driver/SSTC_PFC_Power_Supply/SSTC_PFC_Power_Supply.kicad_pcb

## KiCad design SSTC_PFC_Power_Supply/SSTC_PFC_Power_Supply.kicad_pcb (2022-10-14)

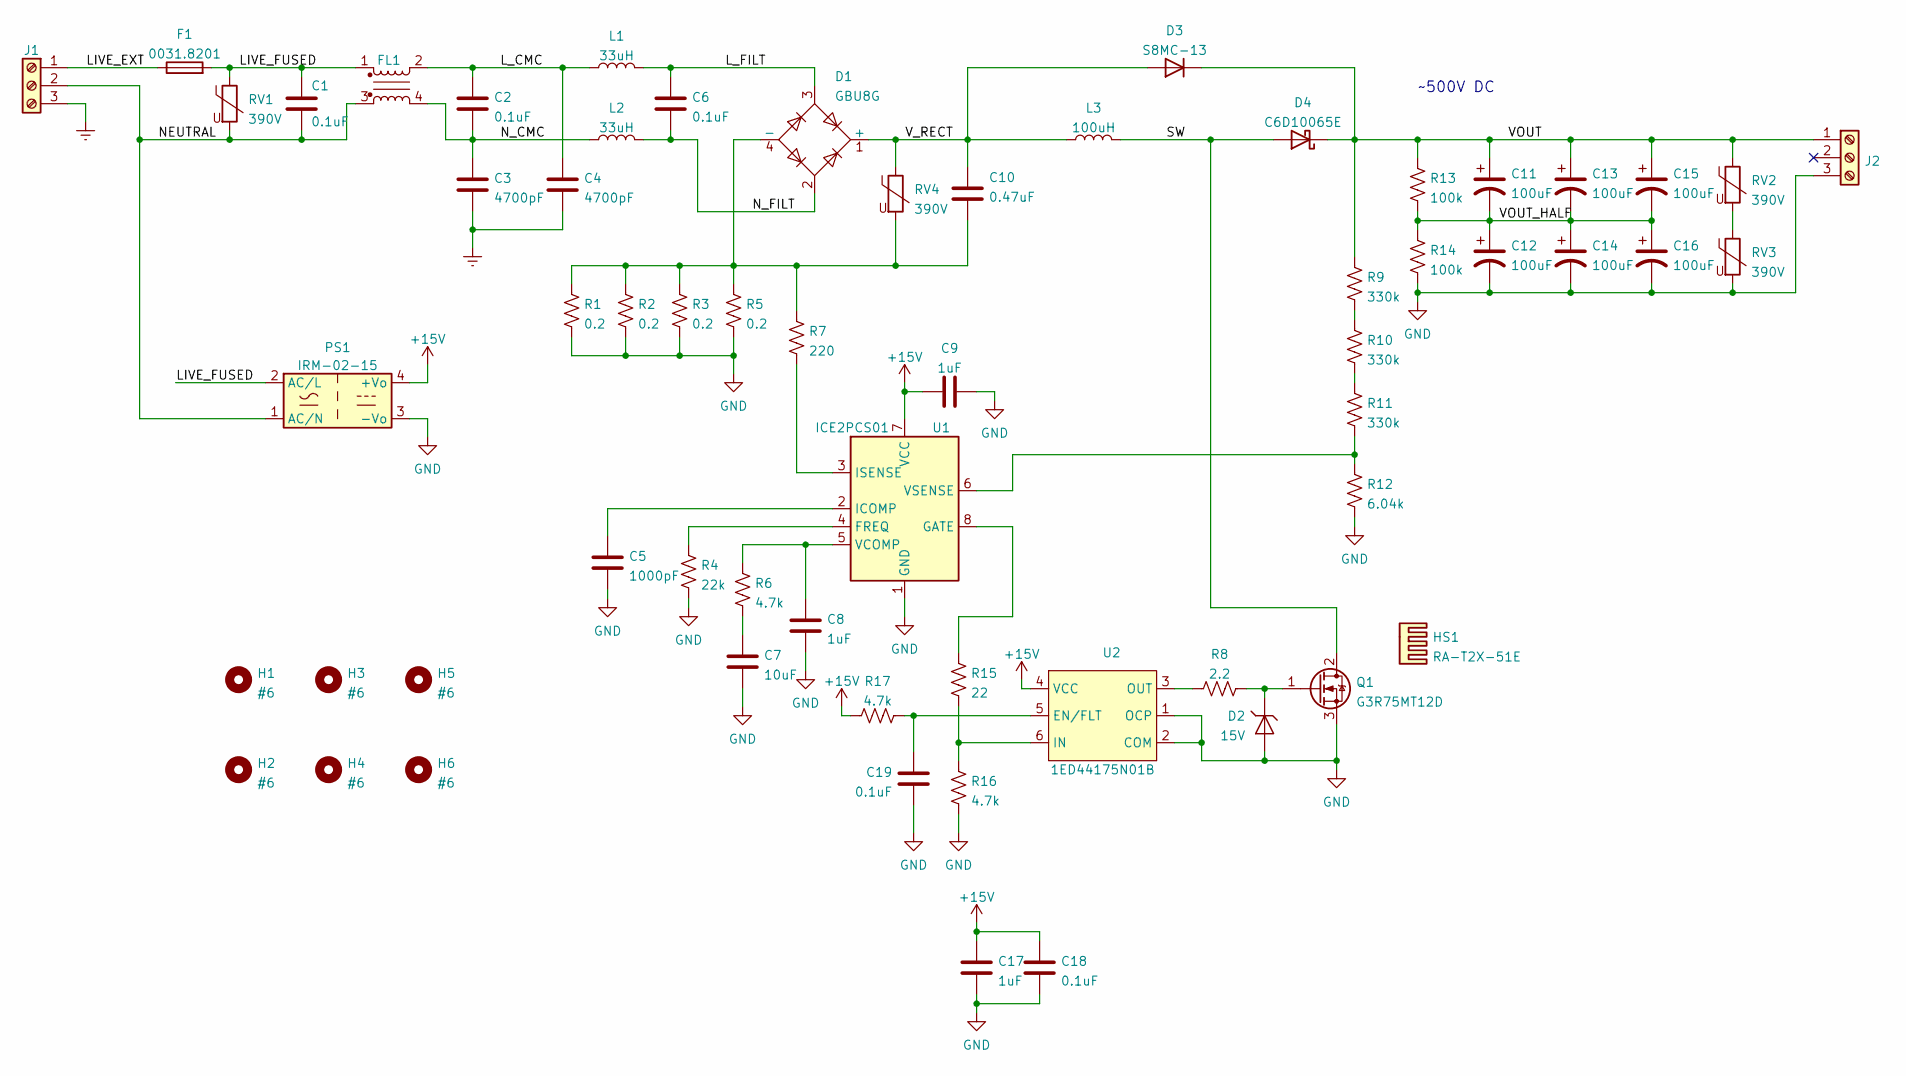
[picture p14: schematic SSTC_PFC_Power_Supply.kicad_sch]

Parts:
C1, C2, C6: 0.1uF; C_Rect_L18.0mm_W6.0mm_P15.00mm_FKS3_FKP3; MFG_PN PHE840MB6100MB05R17
C3, C4: 4700pF; C_Rect_L13.0mm_W4.0mm_P10.00mm_FKS3_FKP3_MKS4; MFG_PN R75PF1470AA01J
C5: 1000pF; C_0805_2012Metric
C7: 10uF; C_1206_3216Metric
C8, C9, C17: 1uF; C_0805_2012Metric
C10: 0.47uF; C_Rect_L18.0mm_W9.0mm_P15.00mm_FKS3_FKP3; MFG_PN B32922C3474K189
C11, C12, C13, C14, C15, C16: 100uF; CP_Radial_D18.0mm_P7.50mm; MFG_PN 450BXW100MEFR18X30
C18, C19: 0.1uF; C_0603_1608Metric
D1: GBU8G; Diode_Bridge_Vishay_GBU
D2: 15V; D_SOD-123
D3: S8MC-13; D_SMC; MFG_PN S8MC-13
D4: C6D10065E; TO-252-2_TabPin1_HV; MFG_PN C6D10065E
F1: 0031.8201; Fuseholder_Cylinder-5x20mm_Schurter_0031_8201_Horizontal_Op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; MFG_PN 0031.8201
FL1: 744824101; Weurth_WE-CMB; MFG_PN 744824101
H1, H2, H3, H4, H5, H6: #6; MountingHole_3.7mm_Pad
HS1: RA-T2X-51E; Ohmite_RA-T2X-51E; MFG_PN RA-T2X-51E
J1, J2: 1766246; PhoenixContact_GMSTBA_2,5_3-G-7,62_1x03_P7.62mm_Horizontal; MFG_PN 1766246
L1, L2: 33uH; L_Wuerth_HCI-2212; MFG_PN 74435583300
L3: 100uH; L_Bourns_1140-101K-RC; MFG_PN 1140-101K-RC
PS1: IRM-02-15; Converter_ACDC_MeanWell_IRM-02-xx_THT
Q1: G3R75MT12D; TO-247-3_Vertical; MFG_PN G3R75MT12D
R1, R2, R3, R5: 0.2; R_2512_6332Metric_High_Power; MFG_PN TLRP3A30CR200FTE
R4: 22k; R_0805_2012Metric
R6, R16, R17: 4.7k; R_0805_2012Metric
R7: 220; R_0805_2012Metric
R8: 2.2; R_0805_2012Metric
R9, R10, R11: 330k; R_1206_3216Metric
R12: 6.04k; R_0805_2012Metric
R13, R14: 100k; R_2512_6332Metric
R15: 22; R_0805_2012Metric
RV1, RV2, RV3, RV4: 390V; RV_Disc_D15.5mm_W4.9mm_P7.5mm; MFG_PN MOV-14D391K
U1: ICE2PCS01; SOIC-8_3.9x4.9mm_P1.27mm
U2: 1ED44175N01B; SOT-23-6; MFG_PN 1ED44175N01BXTSA1

Connections:
+15V: C9.2, C17.1, C18.1, PS1.4 (+Vo), R17.2, U1.7 (VCC), U2.4 (VCC)
/LIVE_EXT: F1.1, J1.1
/LIVE_FUSED: C1.1, F1.2, FL1.1, PS1.2 (AC/L), RV1.1
/L_CMC: C2.1, C4.1, FL1.2, L1.1
/L_FILT: C6.1, D1.3, L1.2
/NEUTRAL: C1.2, FL1.3, J1.2, PS1.1 (AC/N), RV1.2
/N_CMC: C2.2, C3.1, FL1.4, L2.1
/N_FILT: C6.2, D1.2, L2.2
/SW: D4.2 (A), L3.2, Q1.2 (D)
/VOUT: C11.1, C13.1, C15.1, D3.1 (K), D4.1 (K), J2.1, R9.2, R13.2, RV2.1
/VOUT_HALF: C11.2, C12.1, C13.2, C14.1, C15.2, C16.1, R13.1, R14.2
/V_RECT: C10.1, D1.1 (+), D3.2 (A), L3.1, RV4.1
Earth: C3.2, C4.2, J1.3
GND: C5.1, C7.1, C8.1, C9.1, C12.2, C14.2, C16.2, C17.2, C18.2, C19.2, D2.2 (A), J2.3, PS1.3 (-Vo), Q1.3 (S), R1.1, R2.1, R3.1, R4.1, R5.1, R12.1, R14.1, R16.1, RV3.2, U1.1 (GND), U2.1 (OCP), U2.2 (COM)
unnamed: C5.2, U1.2 (ICOMP)
unnamed: C7.2, R6.1
unnamed: C8.2, R6.2, U1.5 (VCOMP)
unnamed: C10.2, D1.4 (-), R1.2, R2.2, R3.2, R5.2, R7.2, RV4.2
unnamed: C19.1, R17.1, U2.5 (EN/FLT)
unnamed: D2.1 (K), Q1.1 (G), R8.1
unnamed: R4.2, U1.4 (FREQ)
unnamed: R7.1, U1.3 (ISENSE)
unnamed: R8.2, U2.3 (OUT)
unnamed: R10.1, R11.2
unnamed: R9.1, R10.2
unnamed: R11.1, R12.2, U1.6 (VSENSE)
unnamed: R15.1, U1.8 (GATE)
unnamed: R15.2, R16.2, U2.6 (IN)
unnamed: RV2.2, RV3.1

Notes on the sheet:
~500V DC

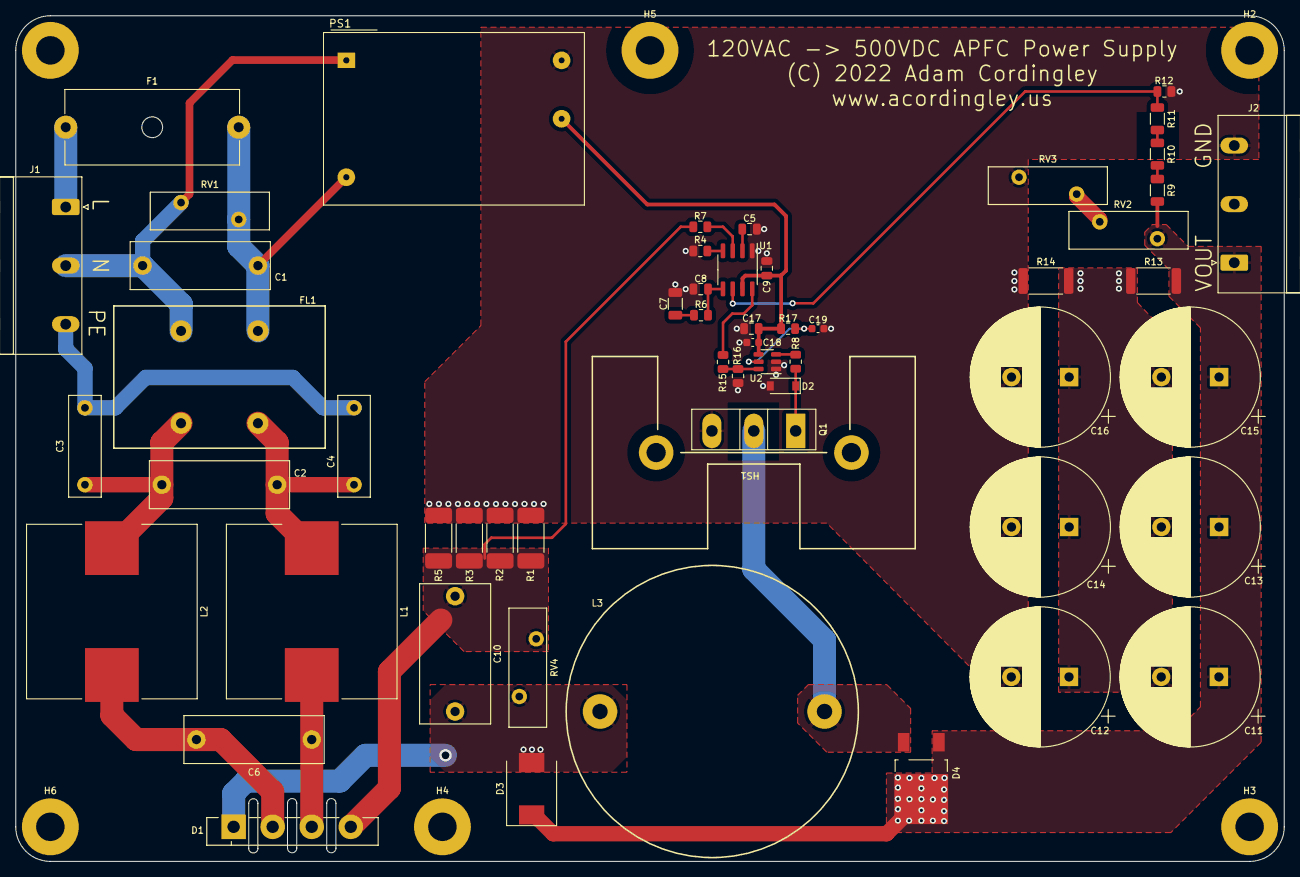
[picture p15: board SSTC_PFC_Power_Supply.kicad_pcb from above]

Board: 2 copper layers, 165.0 x 110.0 mm, 62 parts (0 on the bottom side), 29 nets.
