AdamC19/Musical_SSTC_Driver/SSTC_Power_Switcher/SSTC_Power_Switcher.kicad_pcb

## KiCad design SSTC_Power_Switcher/SSTC_Power_Switcher.kicad_pcb (2022-10-14)

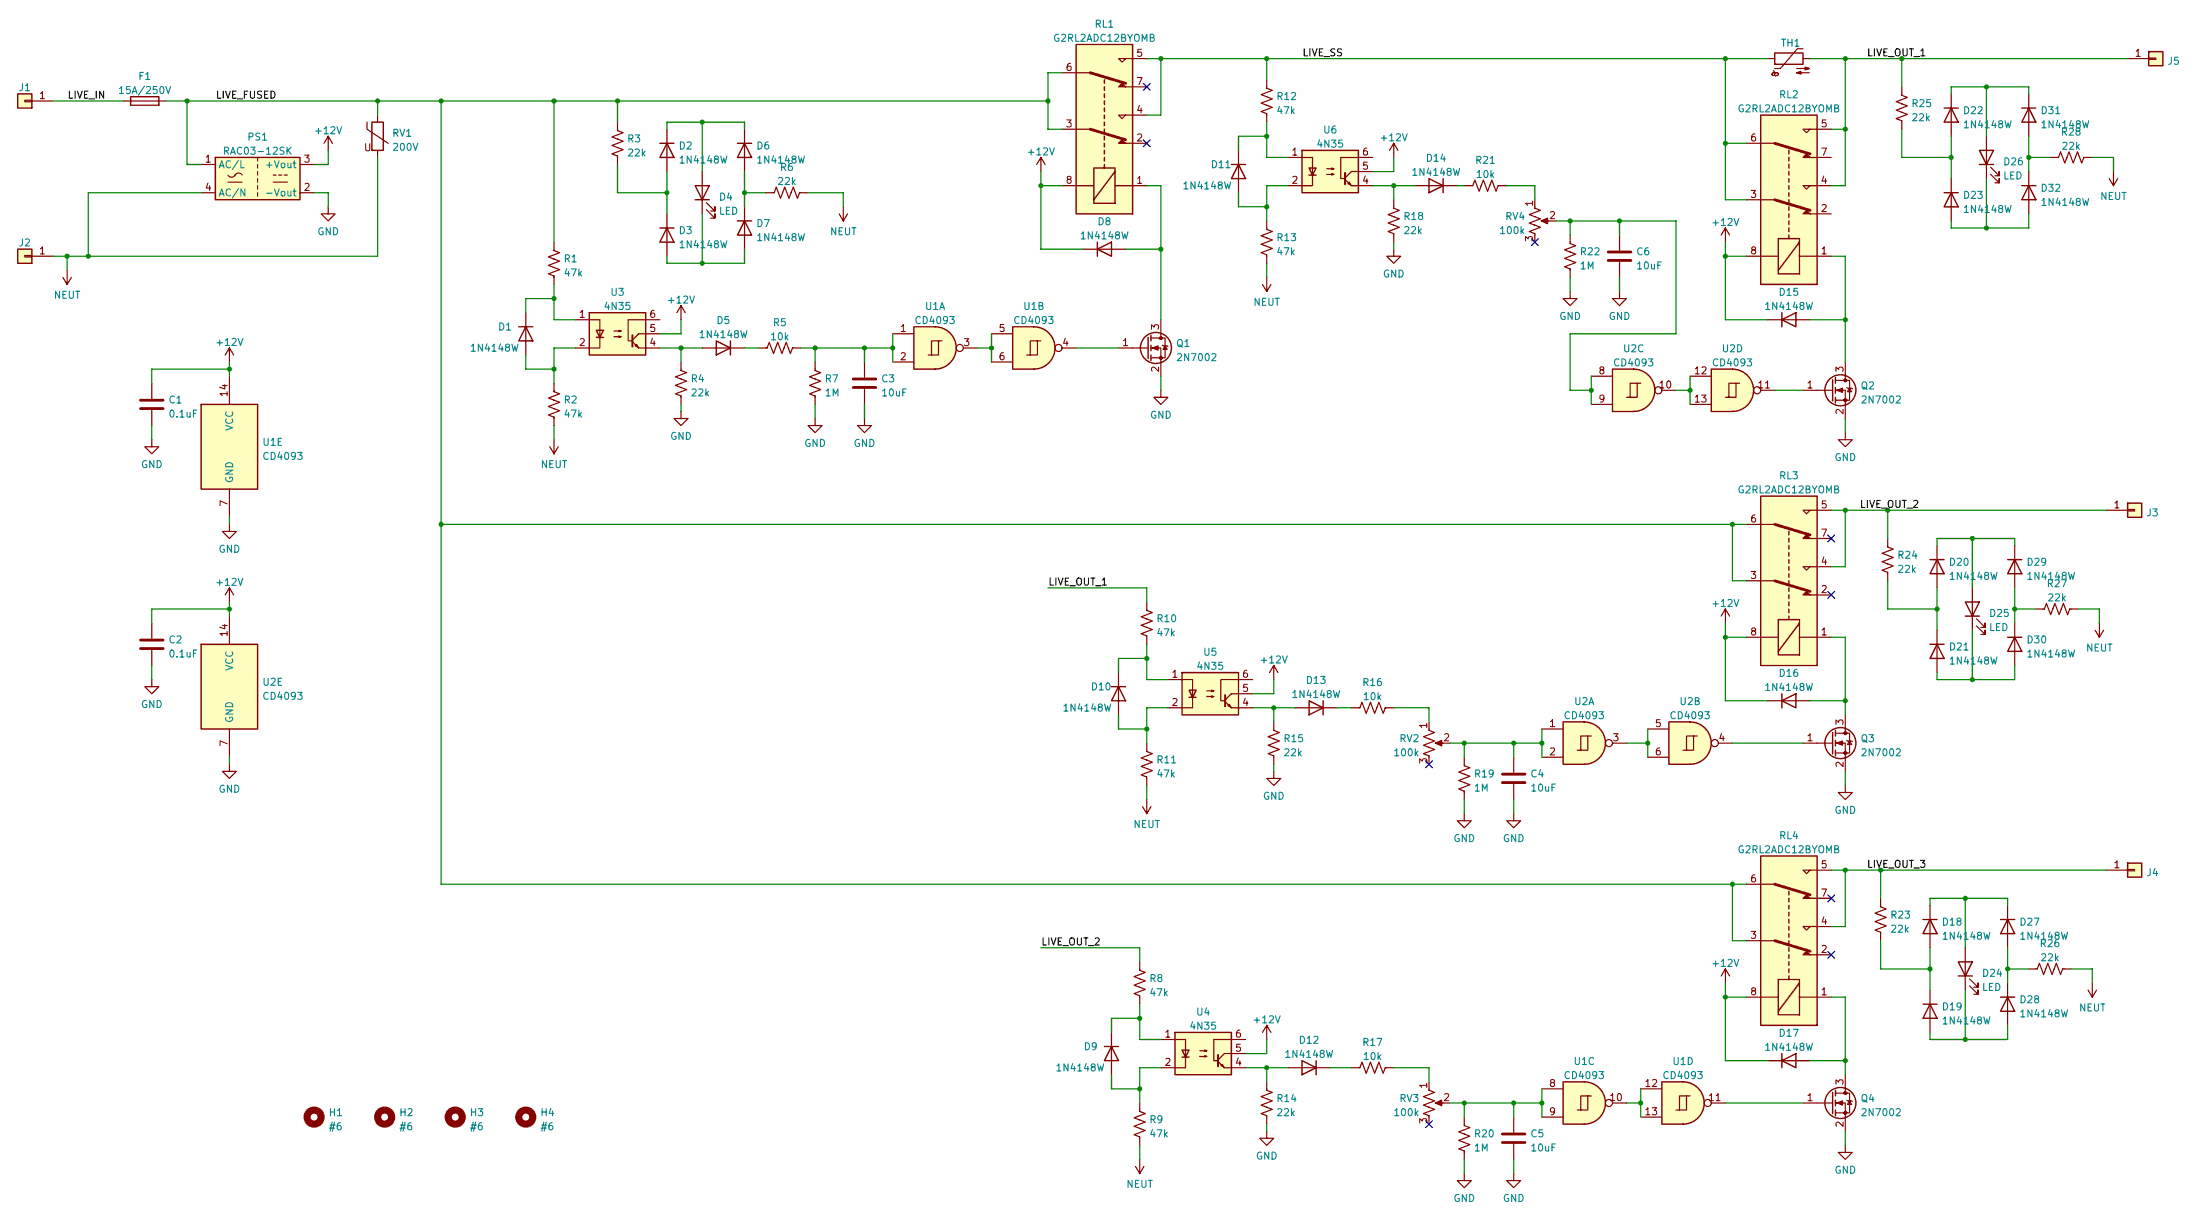
[picture p16: schematic SSTC_Power_Switcher.kicad_sch]

Parts:
C1, C2: 0.1uF; C_0603_1608Metric
C3, C4, C5, C6: 10uF; C_1206_3216Metric
D1, D2, D3, D5, D6, D7, D8, D9, D10, D11, D12, D13, D14, D15, D16, D17, D18, D19, D20, D21, D22, D23, D27, D28, D29, D30, D31, D32: 1N4148W; D_SOD-123
D4, D24, D25, D26: LED; LED_D5.0mm
F1: 15A/250V; Fuseholder_Littelfuse_100_series_5x20mm
H1, H2, H3, H4: #6; MountingHole_3.7mm
J1, J2, J3, J4, J5: Conn_01x01; TE_Connectivity_63824-1
PS1: RAC03-12SK; RAC03-K; MFG_PN RAC03-12SK
Q1, Q2, Q3, Q4: 2N7002; SOT-23
R1, R2, R8, R9, R10, R11, R12, R13: 47k; R_1206_3216Metric
R3, R6, R23, R24, R25, R26, R27, R28: 22k; R_1206_3216Metric
R4, R14, R15, R18: 22k; R_0805_2012Metric
R5, R16, R17, R21: 10k; R_0805_2012Metric
R7, R19, R20, R22: 1M; R_0805_2012Metric
RL1, RL2, RL3, RL4: G2RL2ADC12BYOMB; Relay_DPDT_Omron_G2RL; MFG_PN G2RL2ADC12BYOMB
RV1: 200V; RV_Disc_D12mm_W3.9mm_P7.5mm; MFG_PN MOV-10D201KTR
RV2, RV3, RV4: 100k; Potentiometer_Bourns_3386P_Vertical
TH1: Thermistor_NTC; RV_Disc_D21.5mm_W6.1mm_P7.5mm; MFG_PN SL22 20007
U1, U2: CD4093; SOIC-14_3.9x8.7mm_P1.27mm
U3, U4, U5, U6: 4N35; DIP-6_W7.62mm

Connections:
+12V: C1.1, C2.1, D8.1 (K), D15.1 (K), D16.1 (K), D17.1 (K), PS1.3 (+Vout), RL1.8, RL2.8, RL3.8, RL4.8, U1.14 (VCC), U2.14 (VCC), U3.5, U4.5, U5.5, U6.5
/LIVE_FUSED: F1.2, PS1.1 (AC/L), R1.1, R3.1, RL1.3, RL1.6, RL3.3, RL3.6, RL4.3, RL4.6, RV1.1
/LIVE_IN: F1.1, J1.1
/LIVE_OUT_1: J5.1, R10.1, R25.1, RL2.4, RL2.5, TH1.2
/LIVE_OUT_2: J3.1, R8.1, R24.1, RL3.4, RL3.5
/LIVE_OUT_3: J4.1, R23.1, RL4.4, RL4.5
/LIVE_SS: R12.1, RL1.4, RL1.5, RL2.3, RL2.6, TH1.1
GND: C1.2, C2.2, C3.2, C4.2, C5.2, C6.2, PS1.2 (-Vout), Q1.2 (S), Q2.2 (S), Q3.2 (S), Q4.2 (S), R4.2, R7.2, R14.2, R15.2, R18.2, R19.2, R20.2, R22.2, U1.7 (GND), U2.7 (GND)
NEUT: J2.1, PS1.4 (AC/N), R2.2, R6.2, R9.2, R11.2, R13.2, R26.2, R27.2, R28.2, RV1.2
unnamed: C3.1, R5.2, R7.1, U1.1, U1.2
unnamed: C4.1, R19.1, RV2.2, U2.1, U2.2
unnamed: C5.1, R20.1, RV3.2, U1.8, U1.9
unnamed: C6.1, R22.1, RV4.2, U2.8, U2.9
unnamed: D1.1 (K), R1.2, U3.1
unnamed: D1.2 (A), R2.1, U3.2
unnamed: D2.1 (K), D4.2 (A), D6.1 (K)
unnamed: D2.2 (A), D3.1 (K), R3.2
unnamed: D3.2 (A), D4.1 (K), D7.2 (A)
unnamed: D5.1 (K), R5.1
unnamed: D5.2 (A), R4.1, U3.4
unnamed: D6.2 (A), D7.1 (K), R6.1
unnamed: D8.2 (A), Q1.3 (D), RL1.1
unnamed: D9.1 (K), R8.2, U4.1
unnamed: D9.2 (A), R9.1, U4.2
unnamed: D10.1 (K), R10.2, U5.1
unnamed: D10.2 (A), R11.1, U5.2
unnamed: D11.1 (K), R12.2, U6.1
unnamed: D11.2 (A), R13.1, U6.2
unnamed: D12.1 (K), R17.1
unnamed: D12.2 (A), R14.1, U4.4
unnamed: D13.1 (K), R16.1
unnamed: D13.2 (A), R15.1, U5.4
unnamed: D14.1 (K), R21.1
unnamed: D14.2 (A), R18.1, U6.4
unnamed: D15.2 (A), Q2.3 (D), RL2.1
unnamed: D16.2 (A), Q3.3 (D), RL3.1
unnamed: D17.2 (A), Q4.3 (D), RL4.1
unnamed: D18.1 (K), D24.2 (A), D27.1 (K)
unnamed: D18.2 (A), D19.1 (K), R23.2
unnamed: D19.2 (A), D24.1 (K), D28.2 (A)
unnamed: D20.1 (K), D25.2 (A), D29.1 (K)
unnamed: D20.2 (A), D21.1 (K), R24.2
unnamed: D21.2 (A), D25.1 (K), D30.2 (A)
unnamed: D22.1 (K), D26.2 (A), D31.1 (K)
unnamed: D22.2 (A), D23.1 (K), R25.2
unnamed: D23.2 (A), D26.1 (K), D32.2 (A)
unnamed: D27.2 (A), D28.1 (K), R26.1
unnamed: D29.2 (A), D30.1 (K), R27.1
unnamed: D31.2 (A), D32.1 (K), R28.1
unnamed: Q1.1 (G), U1.4
unnamed: Q2.1 (G), U2.11
unnamed: Q3.1 (G), U2.4
unnamed: Q4.1 (G), U1.11
unnamed: R16.2, RV2.1
unnamed: R17.2, RV3.1
unnamed: R21.2, RV4.1
unnamed: U1.3, U1.5, U1.6
unnamed: U1.10, U1.12, U1.13
unnamed: U2.3, U2.5, U2.6
unnamed: U2.10, U2.12, U2.13

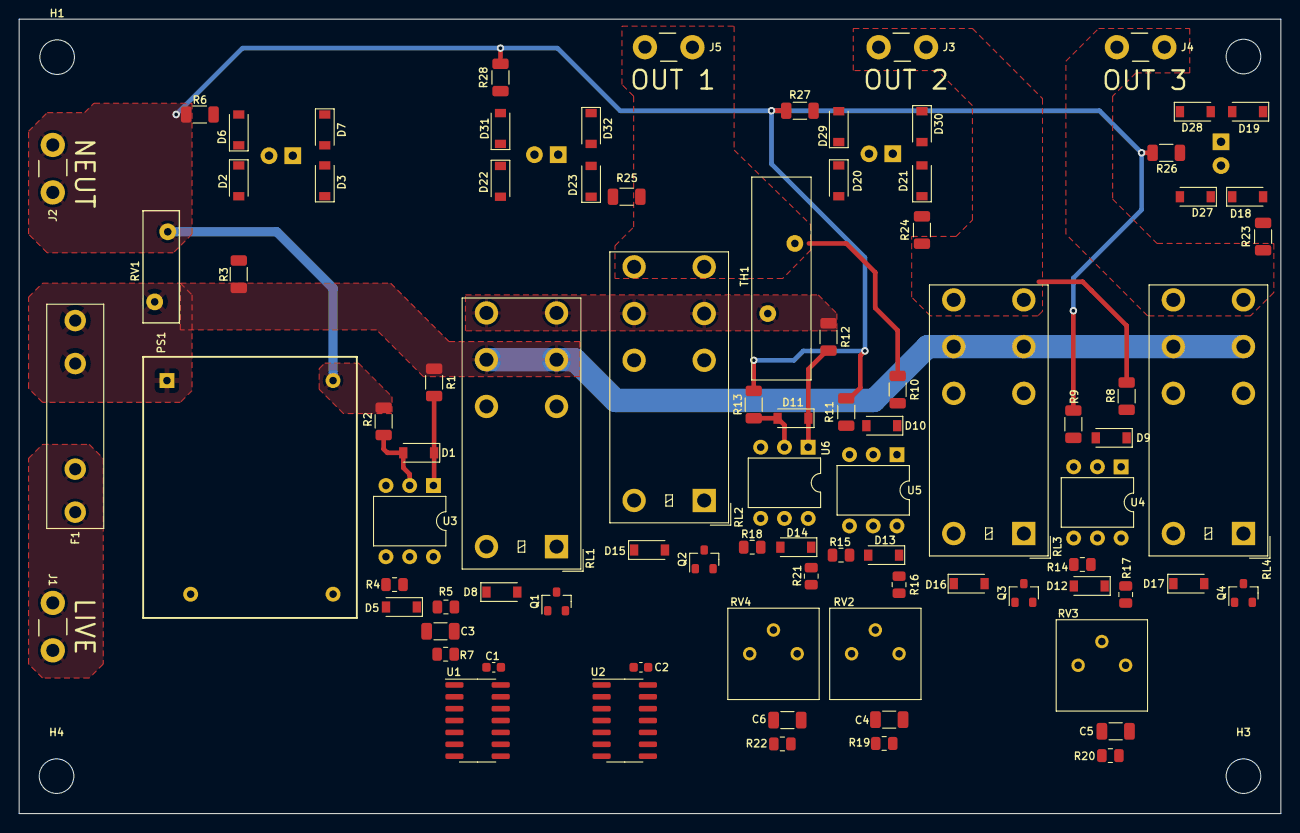
[picture p17: board SSTC_Power_Switcher.kicad_pcb from above]

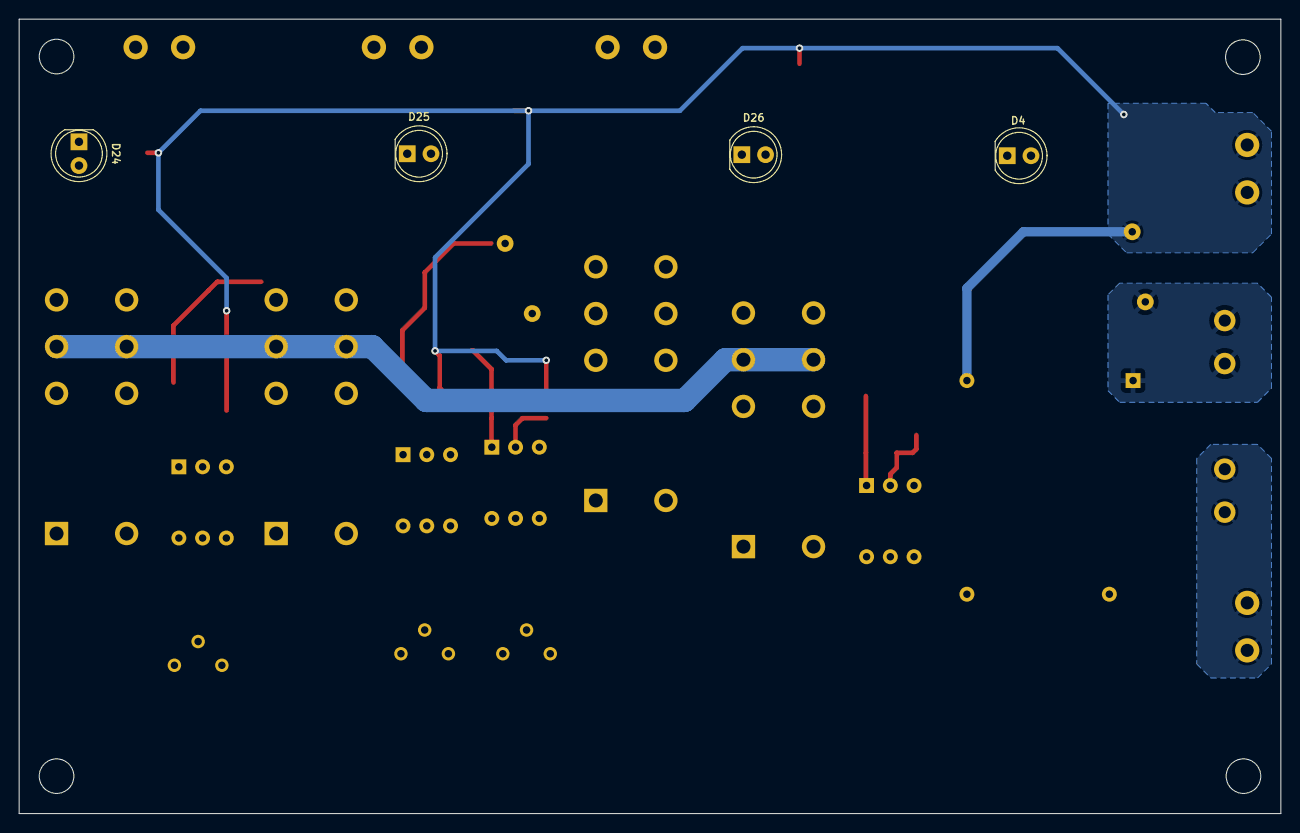
[picture p18: board SSTC_Power_Switcher.kicad_pcb from below]

Board: 2 copper layers, 135.0 x 85.0 mm, 96 parts (4 on the bottom side), 60 nets.
