AdamC19/Musical_SSTC_Driver/SSTC_Full_Bridge_Driver/SSTC_Full_Bridge_Driver.kicad_pcb

## KiCad design SSTC_Full_Bridge_Driver/SSTC_Full_Bridge_Driver.kicad_pcb (2022-10-14)

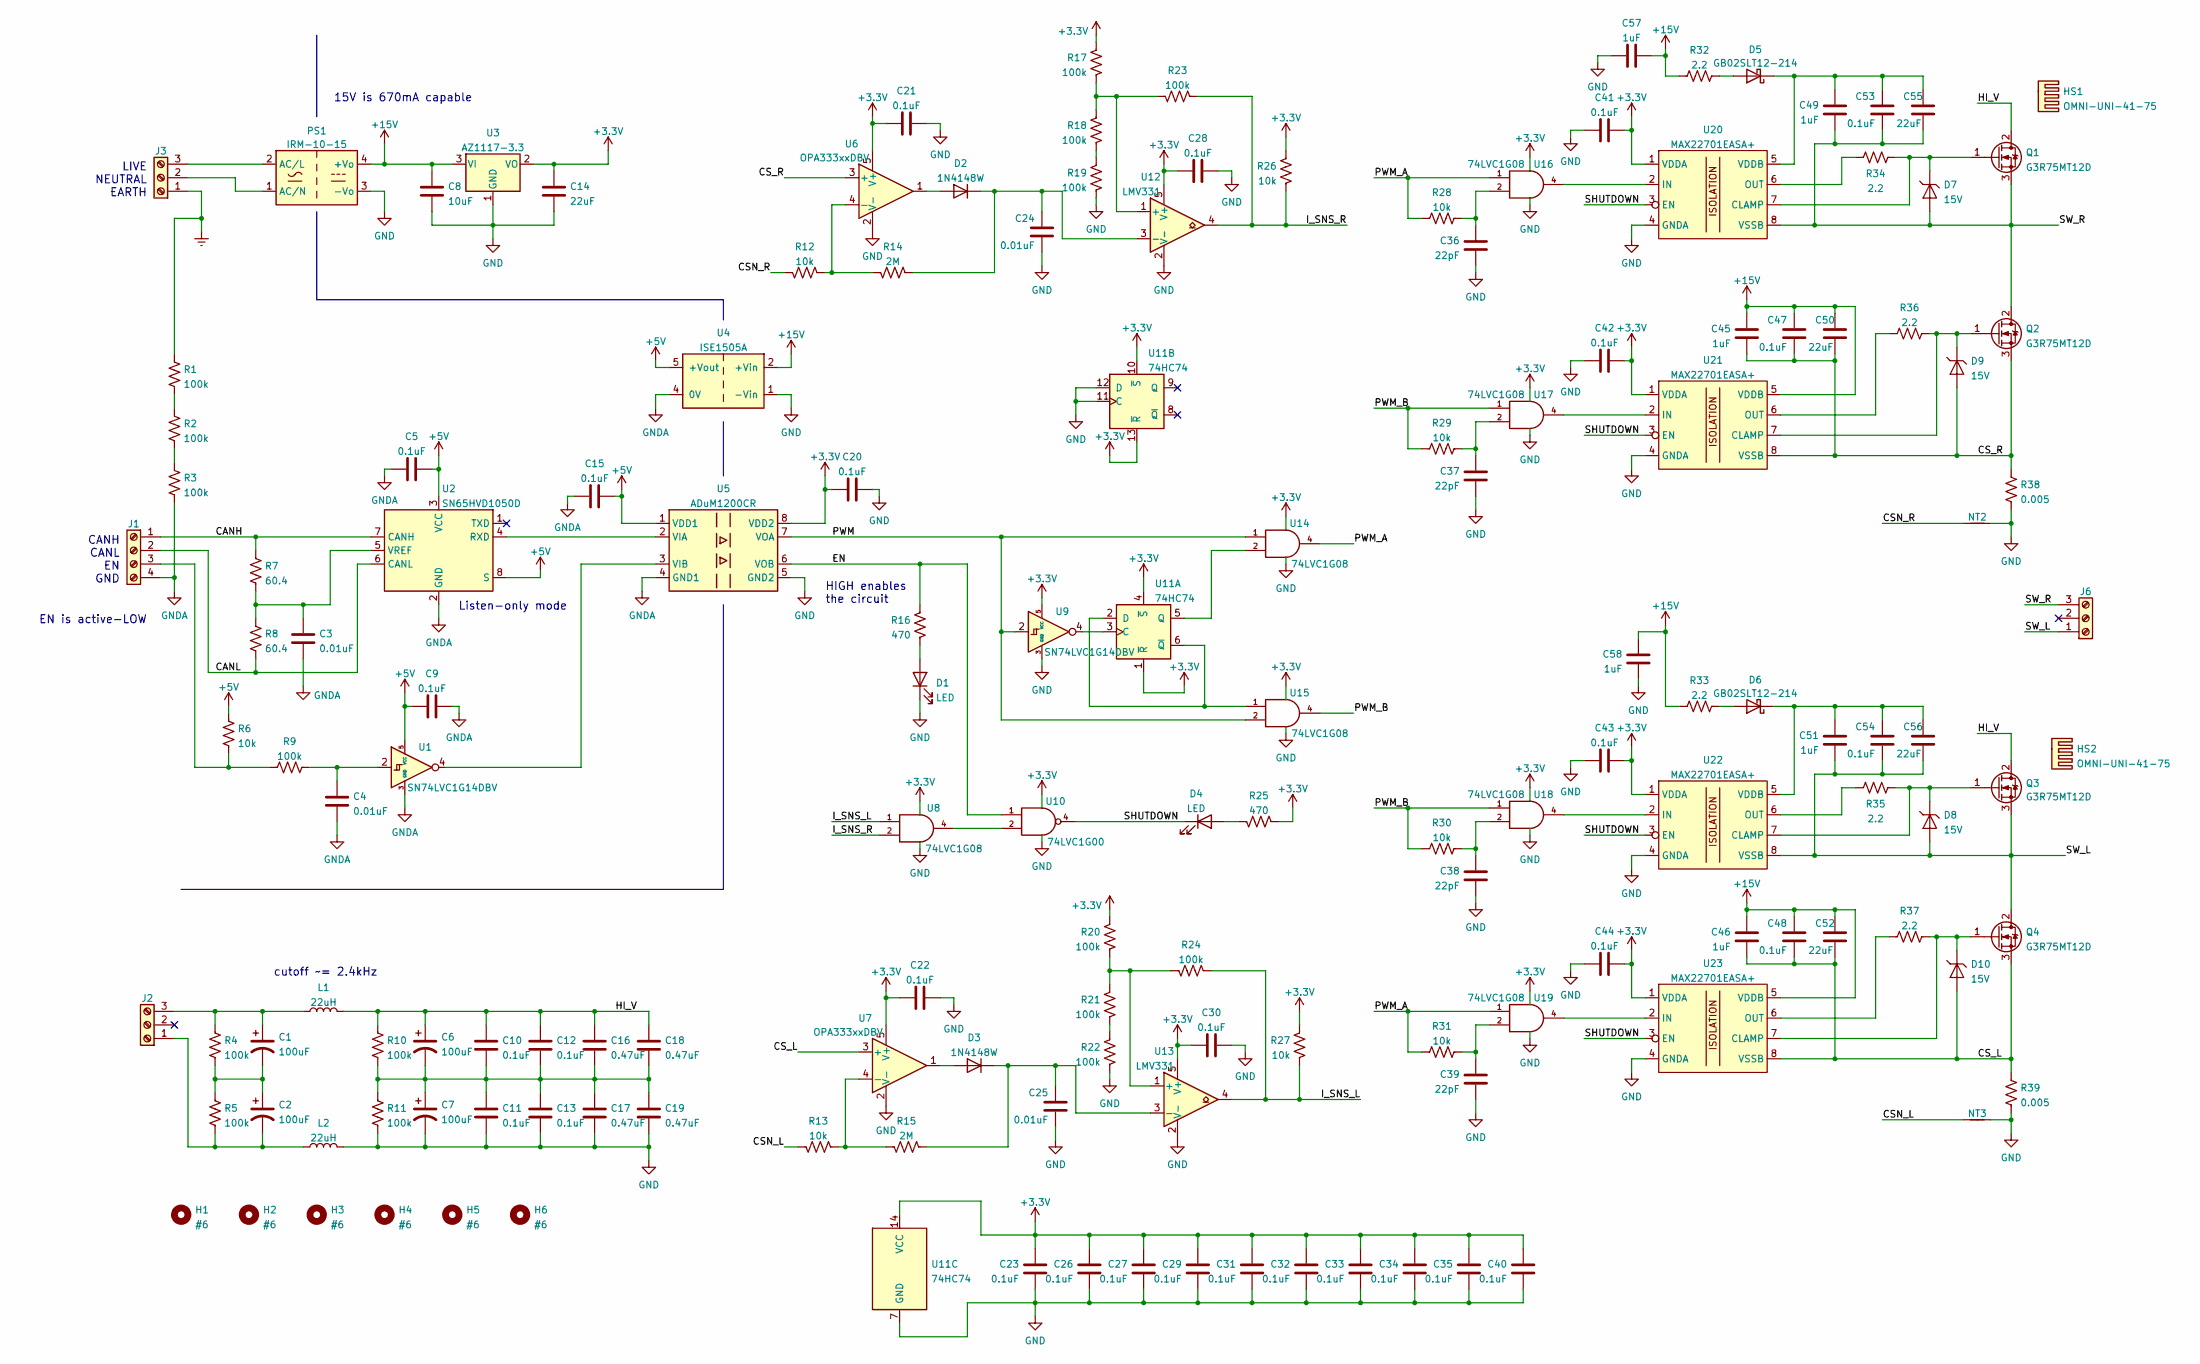
[picture p19: schematic SSTC_Full_Bridge_Driver.kicad_sch]

Parts:
C1, C2, C6, C7: 100uF; CP_Radial_D18.0mm_P7.50mm; MFG_PN 450BXW100MEFR18X30
C3, C4, C24, C25: 0.01uF; C_0603_1608Metric
C5, C9, C15, C20, C21, C22, C23, C26, C27, C28, C29, C30, C31, C32, C33, C34, C35, C40, C41, C42, C43, C44, C47, C48, C53, C54: 0.1uF; C_0603_1608Metric
C8: 10uF; C_1206_3216Metric
C10, C11, C12, C13: 0.1uF; C_1812_4532Metric; MFG_PN C4532X7R2J104K230KA
C14, C50, C52, C55, C56: 22uF; C_1206_3216Metric
C16, C17, C18, C19: 0.47uF; C_1812_4532Metric; MFG_PN C4532X7T2W474K230KA
C36, C37, C38, C39: 22pF; C_0603_1608Metric
C45, C46, C49, C51, C57, C58: 1uF; C_0805_2012Metric
D1, D4: LED; LED_0603_1608Metric
D2, D3: 1N4148W; D_SOD-123
D5, D6: GB02SLT12-214; D_SMB
D7, D8, D9, D10: 15V; D_SOD-123
H1, H2, H3, H4, H5, H6: #6; MountingHole_3.7mm_Pad
HS1, HS2: OMNI-UNI-41-75; Wakefield_Vette_OMNI-UNI-41-75; MFG_PN OMNI-UNI-41-75
J1: Screw_Terminal_01x04; PhoenixContact_MC_1,5_4-G-3.81_1x04_P3.81mm_Horizontal
J2, J3, J6: Screw_Terminal_01x03; PhoenixContact_GMSTBA_2,5_3-G-7,62_1x03_P7.62mm_Horizontal
L1, L2: 22uH; L_Wuerth_WE-PD-Typ-LS; MFG_PN 7447709220
NT2, NT3: NetTie_2; NetTie-2_SMD_Pad0.5mm
PS1: IRM-10-15; Converter_ACDC_MeanWell_IRM-10-xx_THT
Q1, Q2, Q3, Q4: G3R75MT12D; TO-247-3_Vertical; MFG_PN G3R75MT12D
R1, R2, R3, R9, R17, R18, R19, R20, R21, R22, R23, R24: 100k; R_0805_2012Metric
R4, R5, R10, R11: 100k; R_2512_6332Metric
R6, R12, R13, R26, R27, R28, R29, R30, R31: 10k; R_0805_2012Metric
R7, R8: 60.4; R_0805_2012Metric
R14, R15: 2M; R_0805_2012Metric
R16, R25: 470; R_0805_2012Metric
R32, R33, R34, R35, R36, R37: 2.2; R_0805_2012Metric
R38, R39: 0.005; R_1206_3216Metric
U1, U9: SN74LVC1G14DBV; SOT-23-5
U2: SN65HVD1050D; SOIC-8_3.9x4.9mm_P1.27mm
U3: AZ1117-3.3; SOT-89-3
U4: ISE1505A; XP_Power_ISE
U5: ADuM1200CR; SOIC-8_3.9x4.9mm_P1.27mm
U6, U7: OPA333xxDBV; SOT-23-5
U8, U14, U15, U16, U17, U18, U19: 74LVC1G08; SOT-23-5
U10: 74LVC1G00; SOT-23-5
U11: 74HC74; SOIC-14_3.9x8.7mm_P1.27mm
U12, U13: LMV331; SOT-23-5
U20, U21, U22, U23: MAX22701EASA+; SOIC-8_3.9x4.9mm_P1.27mm

Connections:
+3V3: C14.1, C20.1, C21.2, C22.2, C23.2, C26.2, C27.2, C28.2, C29.2, C30.2, C31.2, C32.2, C33.2, C34.2, C35.2, C40.2, C41.2, C42.2, C43.2, C44.2, R17.2, R20.2, R25.2, R26.2, R27.2, U3.2 (VO), U5.8 (VDD2), U6.5 (V+), U7.5 (V+), U8.5 (VCC), U9.5 (VCC), U10.5 (VCC), U11.1 (~R), U11.4 (~S), U11.10 (~S), U11.13 (~R), U11.14 (VCC), U12.5 (V+), U13.5 (V+), U14.5 (VCC), U15.5 (VCC), U16.5 (VCC), U17.5 (VCC), U18.5 (VCC), U19.5 (VCC), U20.1 (VDDA), U21.1 (VDDA), U22.1 (VDDA), U23.1 (VDDA)
+5V: C5.2, C9.1, C15.1, R6.1, U1.5 (VCC), U2.3 (VCC), U2.8 (S), U4.5 (+Vout), U5.1 (VDD1)
+15V: C8.1, C45.2, C46.2, C47.2, C48.2, C50.2, C52.2, C57.1, C58.2, PS1.4 (+Vo), R32.1, R33.1, U3.3 (VI), U4.2 (+Vin), U21.5 (VDDB), U23.5 (VDDB)
/CANH: J1.1, R7.1, U2.7 (CANH)
/CANL: J1.2, R8.2, U2.6 (CANL)
/CSN_L: NT3.1, R13.2
/CSN_R: NT2.1, R12.2
/CS_L: C46.1, C48.1, C52.1, D10.2 (A), Q4.3 (S), R39.2, U7.3 (+), U23.8 (VSSB)
/CS_R: C45.1, C47.1, C50.1, D9.2 (A), Q2.3 (S), R38.2, U6.3 (+), U21.8 (VSSB)
/EN: R16.2, U5.6 (VOB), U10.1
/HI_V: C6.1, C10.2, C12.2, C16.2, C18.2, L1.2, Q1.2 (D), Q3.2 (D), R10.1
/I_SNS_L: R24.2, R27.1, U8.1, U13.4
/I_SNS_R: R23.2, R26.1, U8.2, U12.4
/PWM: U5.7 (VOA), U9.2, U14.1, U15.2
/PWM_A: R28.1, R31.1, U14.4, U16.1, U19.1
/PWM_B: R29.1, R30.1, U15.4, U17.1, U18.1
/SHUTDOWN: D4.1 (K), U10.4, U20.3 (EN), U21.3 (EN), U22.3 (EN), U23.3 (EN)
/SW_L: C51.1, C54.1, C56.1, D8.2 (A), J6.1, Q3.3 (S), Q4.2 (D), U22.8 (VSSB)
/SW_R: C49.1, C53.1, C55.1, D7.2 (A), J6.3, Q1.3 (S), Q2.2 (D), U20.8 (VSSB)
Earth: J3.1, R1.1
GND: C7.2, C8.2, C11.1, C13.1, C14.2, C17.1, C19.1, C20.2, C21.1, C22.1, C23.1, C24.1, C25.1, C26.1, C27.1, C28.1, C29.1, C30.1, C31.1, C32.1, C33.1, C34.1, C35.1, C36.1, C37.1, C38.1, C39.1, C40.1, C41.1, C42.1, C43.1, C44.1, C57.2, C58.1, D1.1 (K), L2.2, NT2.2, NT3.2, PS1.3 (-Vo), R11.2, R19.1, R22.1, R38.1, R39.1, U3.1 (GND), U4.1 (-Vin), U5.5 (GND2), U6.2 (V-), U7.2 (V-), U8.3 (GND), U9.3 (GND), U10.3 (GND), U11.7 (GND), U11.11 (C), U11.12 (D), U12.2 (V-), U13.2 (V-), U14.3 (GND), U15.3 (GND), U16.3 (GND), U17.3 (GND), U18.3 (GND), U19.3 (GND), U20.4 (GNDA), U21.4 (GNDA), U22.4 (GNDA), U23.4 (GNDA)
GNDA: C3.1, C4.1, C5.1, C9.2, C15.2, J1.4, R3.2, U1.3 (GND), U2.2 (GND), U4.4 (0V), U5.4 (GND1)
unnamed: C1.1, J2.3, L1.1, R4.1
unnamed: C1.2, C2.1, R4.2, R5.1
unnamed: C2.2, J2.1, L2.1, R5.2
unnamed: C3.2, R7.2, R8.1, U2.5 (VREF)
unnamed: C4.2, R9.2, U1.2
unnamed: C6.2, C7.1, C10.1, C11.2, C12.1, C13.2, C16.1, C17.2, C18.1, C19.2, R10.2, R11.1
unnamed: C24.2, D2.1 (K), R14.1, U12.3 (-)
unnamed: C25.2, D3.1 (K), R15.1, U13.3 (-)
unnamed: C36.2, R28.2, U16.2
unnamed: C37.2, R29.2, U17.2
unnamed: C38.2, R30.2, U18.2
unnamed: C39.2, R31.2, U19.2
unnamed: C49.2, C53.2, C55.2, D5.1 (K), U20.5 (VDDB)
unnamed: C51.2, C54.2, C56.2, D6.1 (K), U22.5 (VDDB)
unnamed: D1.2 (A), R16.1
unnamed: D2.2 (A), U6.1
unnamed: D3.2 (A), U7.1
unnamed: D4.2 (A), R25.1
unnamed: D7.1 (K), Q1.1 (G), R34.2, U20.7 (CLAMP)
unnamed: D8.1 (K), Q3.1 (G), R35.2, U22.7 (CLAMP)
unnamed: D9.1 (K), Q2.1 (G), R36.2, U21.7 (CLAMP)
unnamed: D10.1 (K), Q4.1 (G), R37.2, U23.7 (CLAMP)
unnamed: J1.3, R6.2, R9.1
unnamed: J3.2, PS1.1 (AC/N)
unnamed: J3.3, PS1.2 (AC/L)
unnamed: R1.2, R2.1
unnamed: R2.2, R3.1
unnamed: R12.1, R14.2, U6.4 (-)
unnamed: R13.1, R15.2, U7.4 (-)
unnamed: R17.1, R18.2, R23.1, U12.1 (+)
unnamed: R18.1, R19.2
unnamed: R20.1, R21.2, R24.1, U13.1 (+)
unnamed: R21.1, R22.2
unnamed: D5.2 (A), R32.2
unnamed: D6.2 (A), R33.2
unnamed: R34.1, U20.6 (OUT)
unnamed: R35.1, U22.6 (OUT)
unnamed: R36.1, U21.6 (OUT)
unnamed: R37.1, U23.6 (OUT)
unnamed: U1.4, U5.3 (VIB)
unnamed: U2.4 (RXD), U5.2 (VIA)
unnamed: U8.4, U10.2
unnamed: U11.2 (D), U11.6 (~Q), U15.1
unnamed: U9.4, U11.3 (C)
unnamed: U11.5 (Q), U14.2
unnamed: U16.4, U20.2 (IN)
unnamed: U17.4, U21.2 (IN)
unnamed: U18.4, U22.2 (IN)
unnamed: U19.4, U23.2 (IN)

Notes on the sheet:
CANH CANL EN GND
EN is active-LOW
15V is 670mA capable
cutoff ~= 2.4kHz
Listen-only mode
HIGH enables the circuit
LIVE NEUTRAL EARTH

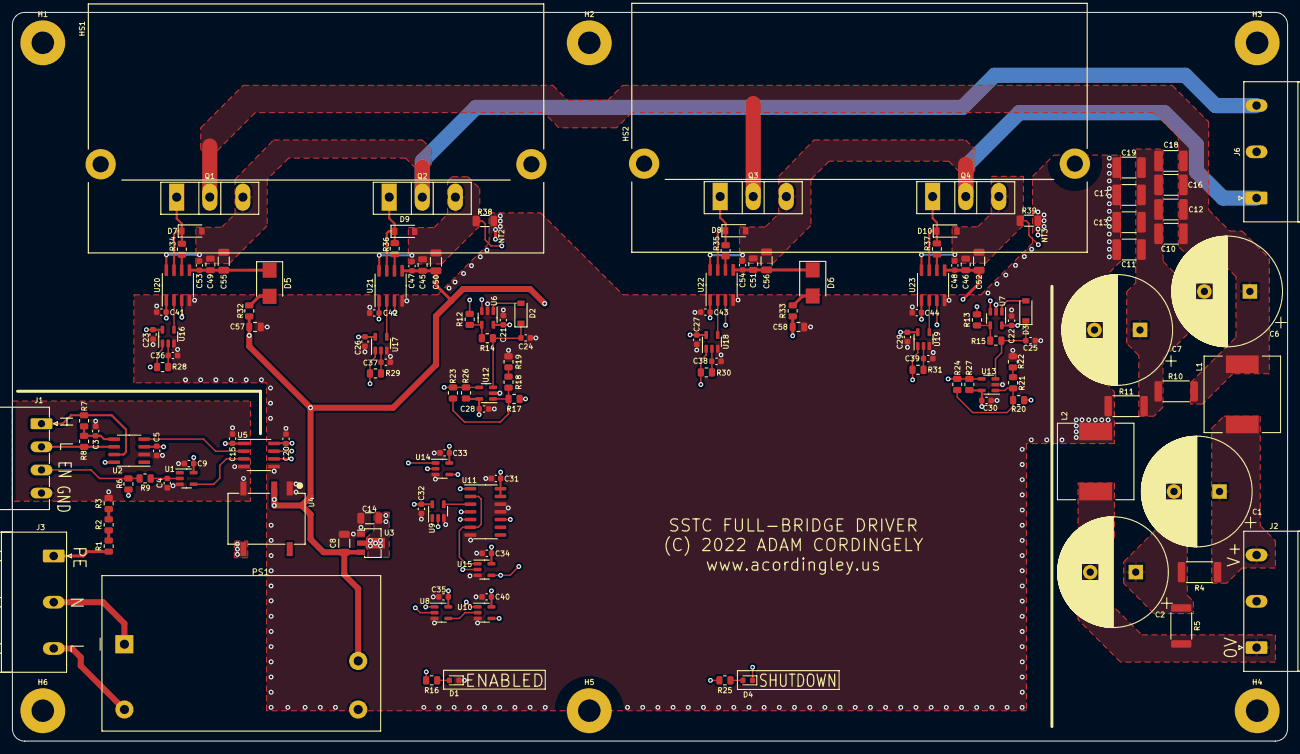
[picture p20: board SSTC_Full_Bridge_Driver.kicad_pcb from above]

Board: 4 copper layers, 210.0 x 120.0 mm, 151 parts (0 on the bottom side), 71 nets.
