AdamC19/Musical_SSTC_Driver/SSTC_Switch_Board/SSTC_Switch_Board.kicad_pcb

## KiCad design SSTC_Switch_Board/SSTC_Switch_Board.kicad_pcb (2022-02-14)

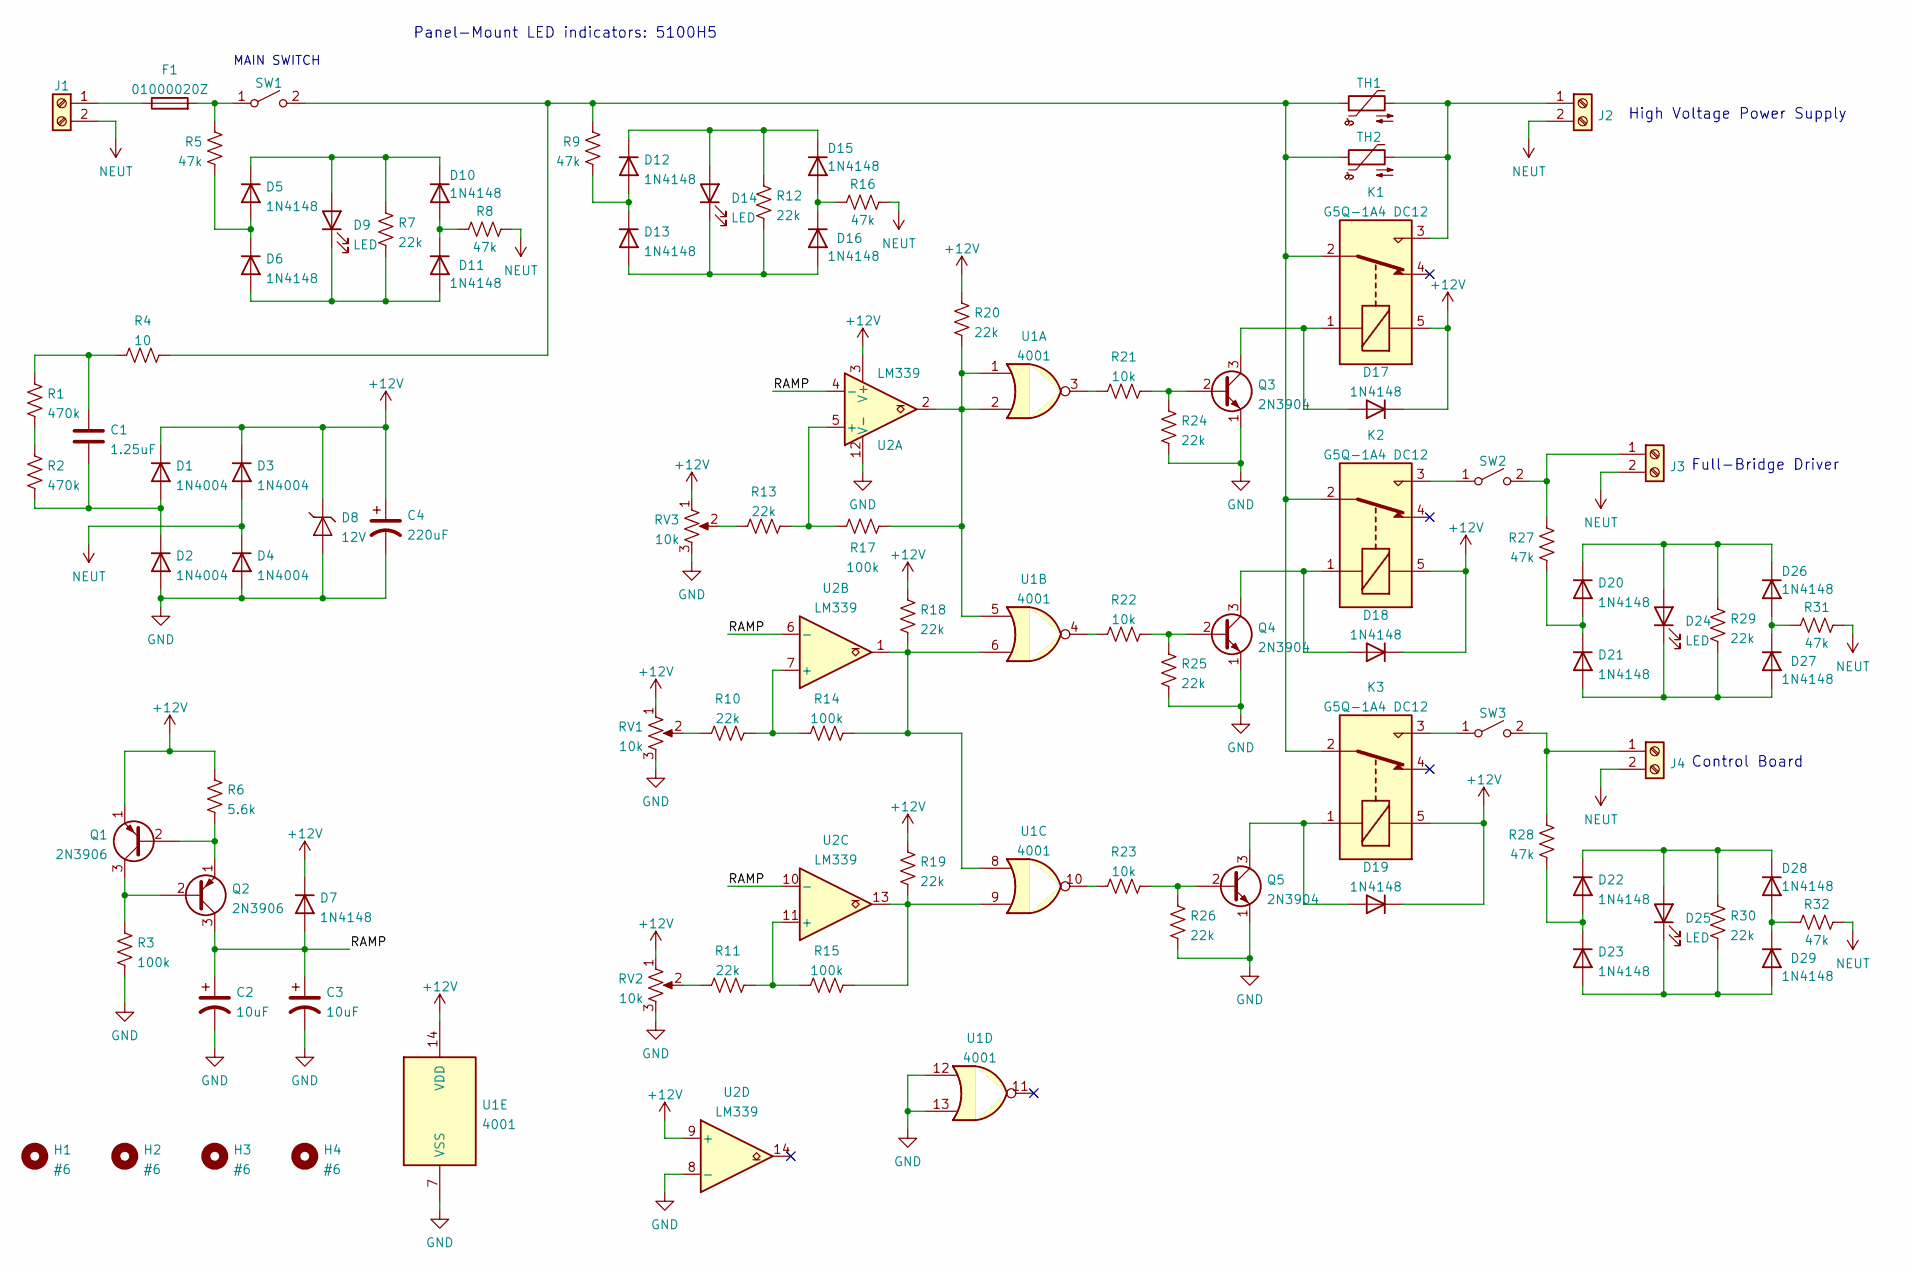
[picture p21: schematic SSTC_Switch_Board.kicad_sch]

Parts:
C1: 1.25uF; C_Rect_L24.0mm_W8.3mm_P22.50mm_MKT
C2, C3: 10uF; CP_Radial_D6.3mm_P2.50mm
C4: 220uF; CP_Radial_D10.0mm_P5.00mm
D1, D2, D3, D4: 1N4004; D_DO-41_SOD81_P10.16mm_Horizontal
D5, D6, D7, D10, D11, D12, D13, D15, D16, D17, D18, D19, D20, D21, D22, D23, D26, D27, D28, D29: 1N4148; D_DO-35_SOD27_P7.62mm_Horizontal
D8: 12V; D_DO-41_SOD81_P10.16mm_Horizontal
D9, D14, D24, D25: LED; JST_XH_B2B-XH-A_1x02_P2.50mm_Vertical; MFG_PN B2B-XH-A(LF)(SN)
F1: 01000020Z; Fuseholder_Littelfuse_100_series_5x20mm; MFG_PN 01000020Z
H1, H2, H3, H4: #6; MountingHole_3.7mm_Pad
J1, J2, J3, J4: Screw_Terminal_01x02; PhoenixContact_GMSTBVA_2,5_2-G-7,62_1x02_P7.62mm_Vertical
K1, K2, K3: G5Q-1A4 DC12; Relay_SPDT_Omron-G5Q-1; MFG_PN G5Q-1A4 DC12
Q1, Q2: 2N3906; TO-92_Inline_Wide
Q3, Q4, Q5: 2N3904; TO-92_Inline_Wide
R1, R2: 470k; R_Axial_DIN0207_L6.3mm_D2.5mm_P10.16mm_Horizontal
R3, R14, R15, R17: 100k; R_Axial_DIN0207_L6.3mm_D2.5mm_P10.16mm_Horizontal
R4: 10; R_Axial_DIN0414_L11.9mm_D4.5mm_P15.24mm_Horizontal
R5, R8, R9, R16, R27, R28, R31, R32: 47k; R_Axial_DIN0207_L6.3mm_D2.5mm_P10.16mm_Horizontal
R6: 5.6k; R_Axial_DIN0207_L6.3mm_D2.5mm_P10.16mm_Horizontal
R7, R10, R11, R12, R13, R18, R19, R20, R26, R29, R30: 22k; R_Axial_DIN0207_L6.3mm_D2.5mm_P10.16mm_Horizontal
R21, R22, R23: 10k; R_Axial_DIN0207_L6.3mm_D2.5mm_P10.16mm_Horizontal
R24, R25: 22k; R_Axial_DIN0207_L6.3mm_D2.5mm_P2.54mm_Vertical
RV1, RV2, RV3: 10k; Potentiometer_Bourns_3386P_Vertical
SW1, SW2, SW3: SW_SPST; PhoenixContact_GMSTBVA_2,5_2-G-7,62_1x02_P7.62mm_Vertical
TH1, TH2: B57238S0220M051; RV_Disc_D15.5mm_W5.9mm_P7.5mm; MFG_PN B57238S0220M051
U1: 4001; DIP-14_W7.62mm
U2: LM339; DIP-14_W7.62mm

Connections:
+12V: C4.1, D1.1 (K), D3.1 (K), D7.1 (K), D8.1 (K), D17.1 (K), D18.1 (K), D19.1 (K), K1.5, K2.5, K3.5, Q1.1 (E), R6.1, R18.2, R19.2, R20.2, RV1.1, RV2.1, RV3.1, U1.14 (VDD), U2.3 (V+), U2.9 (+)
/RAMP: C2.1, C3.1, D7.2 (A), Q2.3 (C), U2.4 (-), U2.6 (-), U2.10 (-)
GND: C2.2, C3.2, C4.2, D2.2 (A), D4.2 (A), D8.2 (A), Q3.1 (E), Q4.1 (E), Q5.1 (E), R3.2, R24.1, R25.1, R26.1, RV1.3, RV2.3, RV3.3, U1.7 (VSS), U1.12, U1.13, U2.8 (-), U2.12 (V-)
NEUT: D3.2 (A), D4.1 (K), J1.2, J2.2, J3.2, J4.2, R8.1, R16.1, R31.1, R32.1
unnamed: C1.1, R1.1, R4.2
unnamed: C1.2, D1.2 (A), D2.1 (K), R2.2
unnamed: D5.2 (A), D6.1 (K), R5.2
unnamed: D5.1 (K), D9.2 (A), D10.1 (K), R7.2
unnamed: D10.2 (A), D11.1 (K), R8.2
unnamed: D6.2 (A), D9.1 (K), D11.2 (A), R7.1
unnamed: D12.1 (K), D14.2 (A), D15.1 (K), R12.2
unnamed: D12.2 (A), D13.1 (K), R9.2
unnamed: D13.2 (A), D14.1 (K), D16.2 (A), R12.1
unnamed: D15.2 (A), D16.1 (K), R16.2
unnamed: D17.2 (A), K1.1, Q3.3 (C)
unnamed: D18.2 (A), K2.1, Q4.3 (C)
unnamed: D19.2 (A), K3.1, Q5.3 (C)
unnamed: D20.1 (K), D24.2 (A), D26.1 (K), R29.2
unnamed: D20.2 (A), D21.1 (K), R27.2
unnamed: D21.2 (A), D24.1 (K), D27.2 (A), R29.1
unnamed: D22.1 (K), D25.2 (A), D28.1 (K), R30.2
unnamed: D22.2 (A), D23.1 (K), R28.2
unnamed: D23.2 (A), D25.1 (K), D29.2 (A), R30.1
unnamed: D26.2 (A), D27.1 (K), R31.2
unnamed: D28.2 (A), D29.1 (K), R32.2
unnamed: F1.1, J1.1
unnamed: F1.2, R5.1, SW1.1 (A)
unnamed: J2.1, K1.3, TH1.2, TH2.2
unnamed: J3.1, R27.1, SW2.2 (B)
unnamed: J4.1, R28.1, SW3.2 (B)
unnamed: K1.2, K2.2, K3.2, R4.1, R9.1, SW1.2 (B), TH1.1, TH2.1
unnamed: K2.3, SW2.1 (A)
unnamed: K3.3, SW3.1 (A)
unnamed: Q1.2 (B), Q2.1 (E), R6.2
unnamed: Q1.3 (C), Q2.2 (B), R3.1
unnamed: Q3.2 (B), R21.2, R24.2
unnamed: Q4.2 (B), R22.2, R25.2
unnamed: Q5.2 (B), R23.2, R26.2
unnamed: R1.2, R2.1
unnamed: R10.1, RV1.2
unnamed: R10.2, R14.1, U2.7 (+)
unnamed: R11.1, RV2.2
unnamed: R11.2, R15.1, U2.11 (+)
unnamed: R13.1, RV3.2
unnamed: R13.2, R17.1, U2.5 (+)
unnamed: R14.2, R18.1, U1.6, U1.8, U2.1
unnamed: R15.2, R19.1, U1.9, U2.13
unnamed: R17.2, R20.1, U1.1, U1.2, U1.5, U2.2
unnamed: R21.1, U1.3
unnamed: R22.1, U1.4
unnamed: R23.1, U1.10

Notes on the sheet:
Panel-Mount LED indicators: 5100H5
High Voltage Power Supply
Full-Bridge Driver
MAIN SWITCH
Control Board

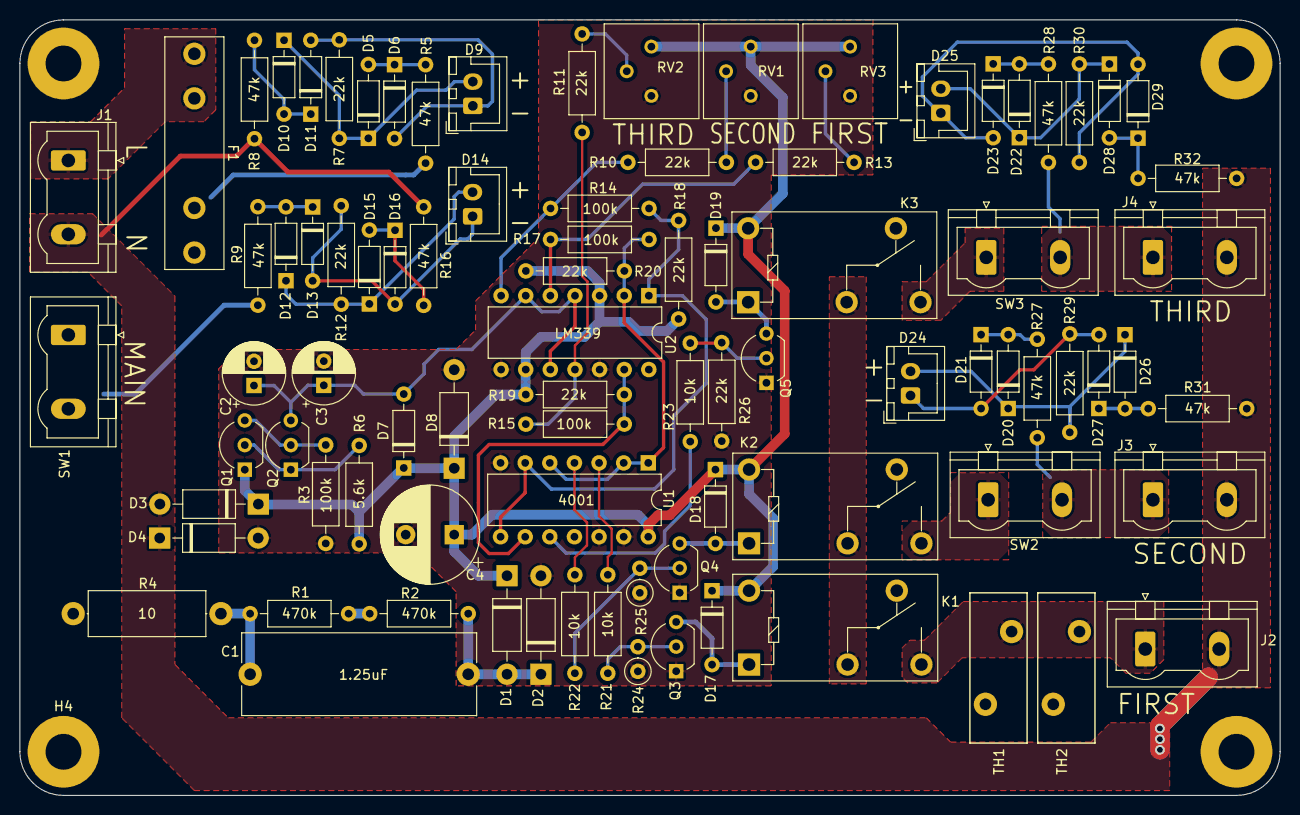
[picture p22: board SSTC_Switch_Board.kicad_pcb from above]

Board: 2 copper layers, 130.0 x 80.0 mm, 92 parts (0 on the bottom side), 51 nets.
