AdamC19/Musical_SSTC_Driver/(commit log)

2022-02-14 Audio isolator stuff and small changes
    [Audio_Isolator.kicad_pcb, Audio_Isolator.kicad_sch, SSTC_Control_Board.kicad_pcb, SSTC_Control_Board.kicad_sch, SSTC_Full_Bridge_Driver.kicad_pcb, SSTC_Full_Bridge_Driver.kicad_sch, SSTC_PFC_Power_Supply.kicad_pcb, SSTC_Switch_Board.kicad_pcb]
2022-02-15 Finish Audio Isolator layout, begin routing
    [Audio_Isolator.kicad_pcb]
2022-10-14 Files sent out for fabrication
    [Audio_Isolator.kicad_pcb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]
