AdamC19/Musical_SSTC_Driver/(notices)

Notices in the files:
SSTC_Full_Bridge_Driver/SSTC_Full_Bridge_Driver.kicad_pcb:
(C) 2022 ADAM CORDINGELY
SSTC_PFC_Power_Supply/SSTC_PFC_Power_Supply.kicad_pcb:
(C) 2022 Adam Cordingley
SSTC_Audio_Isolator/SSTC_Audio_Isolator.kicad_pcb:
AUDIO ISOLATOR | (C) 2022 ADAM CORDINGLEY | www.acordingley.us
